m4v/Proyecto-final/mediciones/graficos/horno_ensayo_1.png

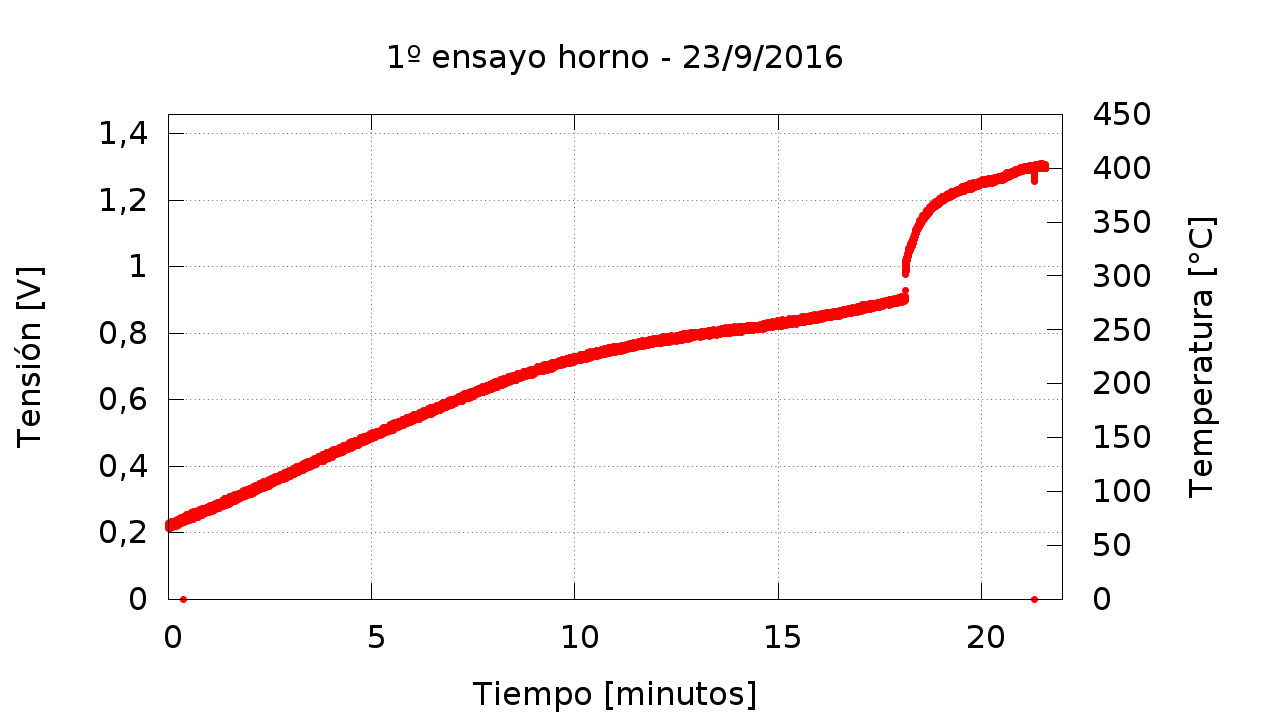
mediciones/graficos/horno_ensayo_1.png
