m4v/Proyecto-final/mediciones/graficos/horno_ensayo_2.png

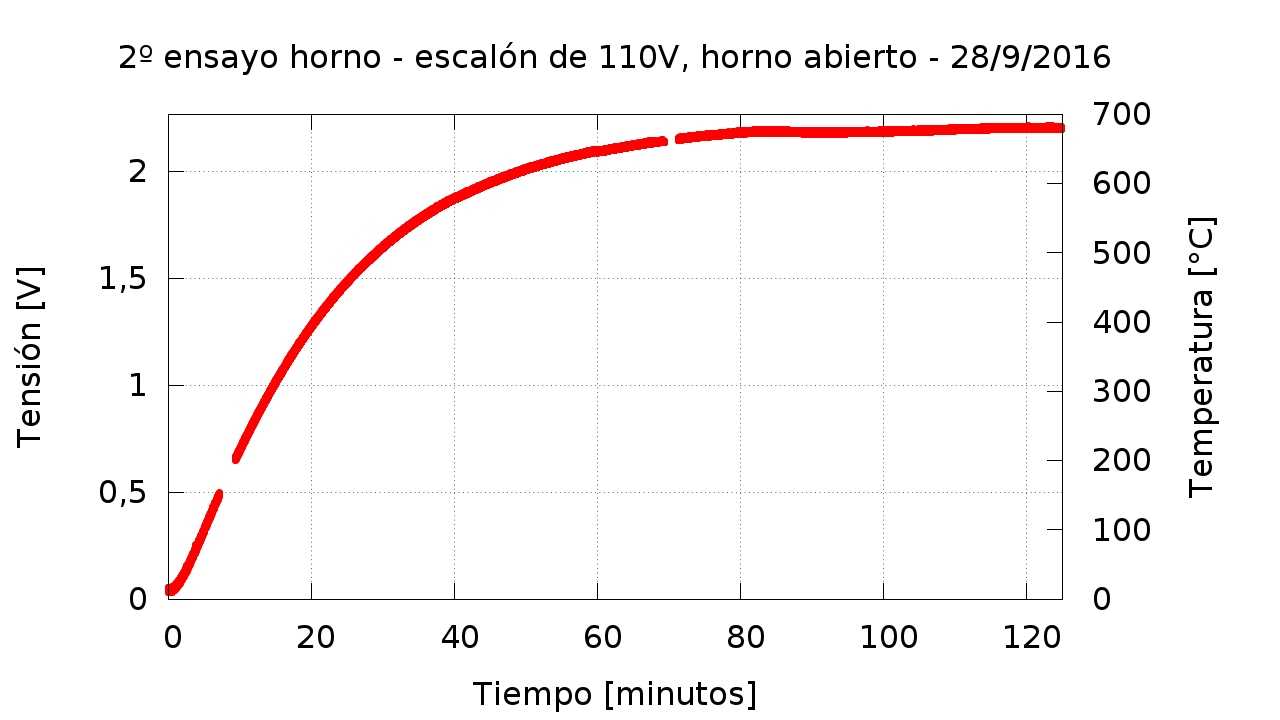
mediciones/graficos/horno_ensayo_2.png
