m4v/Proyecto-final/mediciones/graficos/horno_ensayo_3.png

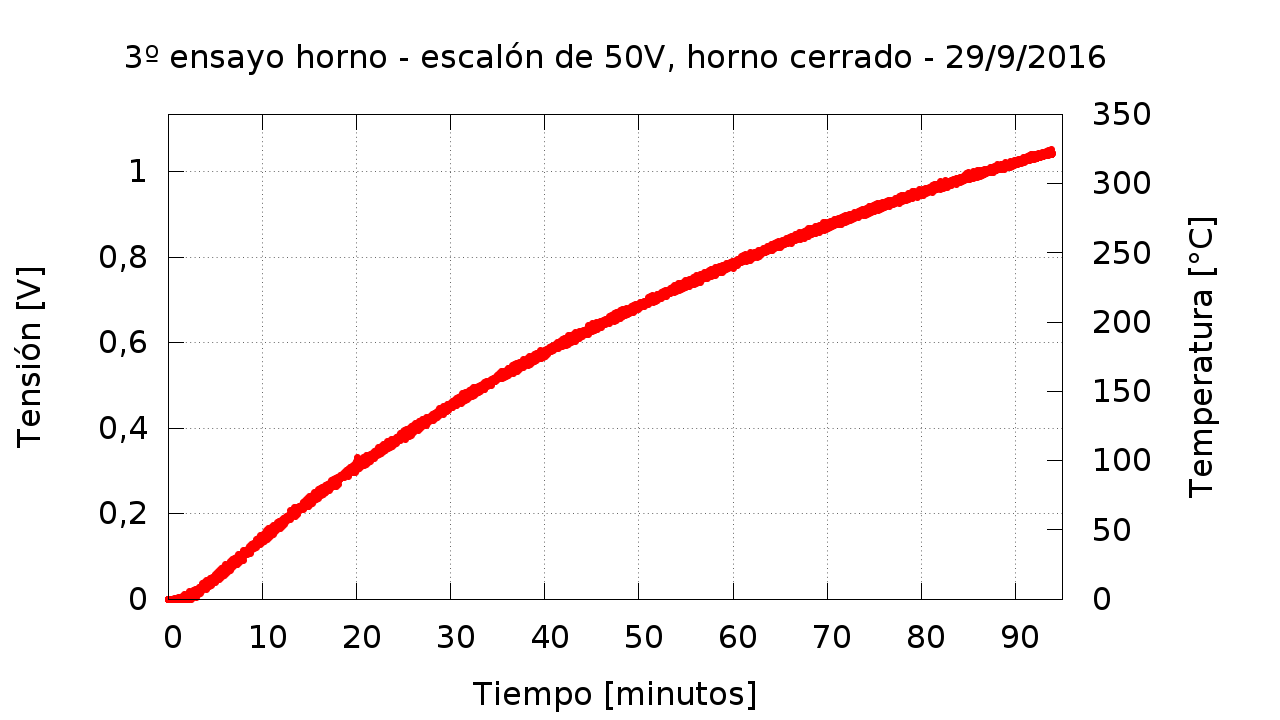
mediciones/graficos/horno_ensayo_3.png
