m4v/Proyecto-final/mediciones/graficos/horno_ensayo_2016-10-04.png

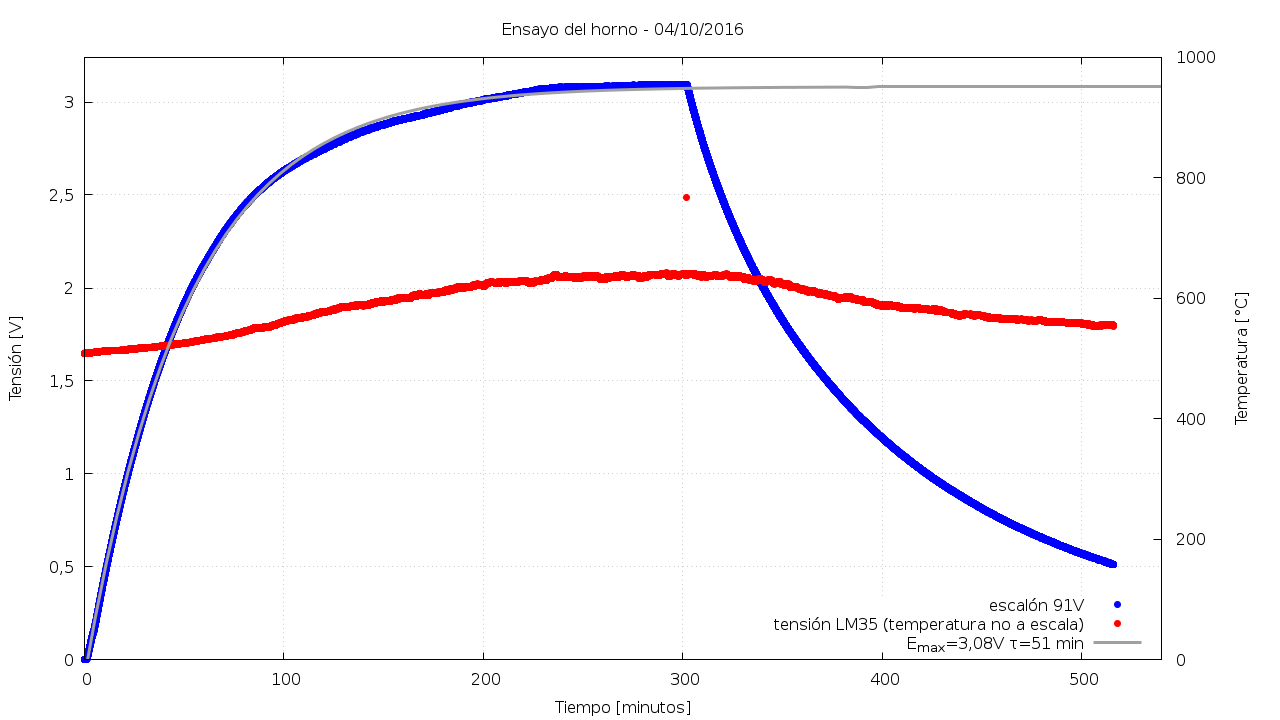
mediciones/graficos/horno_ensayo_2016-10-04.png
