m4v/Proyecto-final/mediciones/graficos/horno_ensayos_2_y_3.png

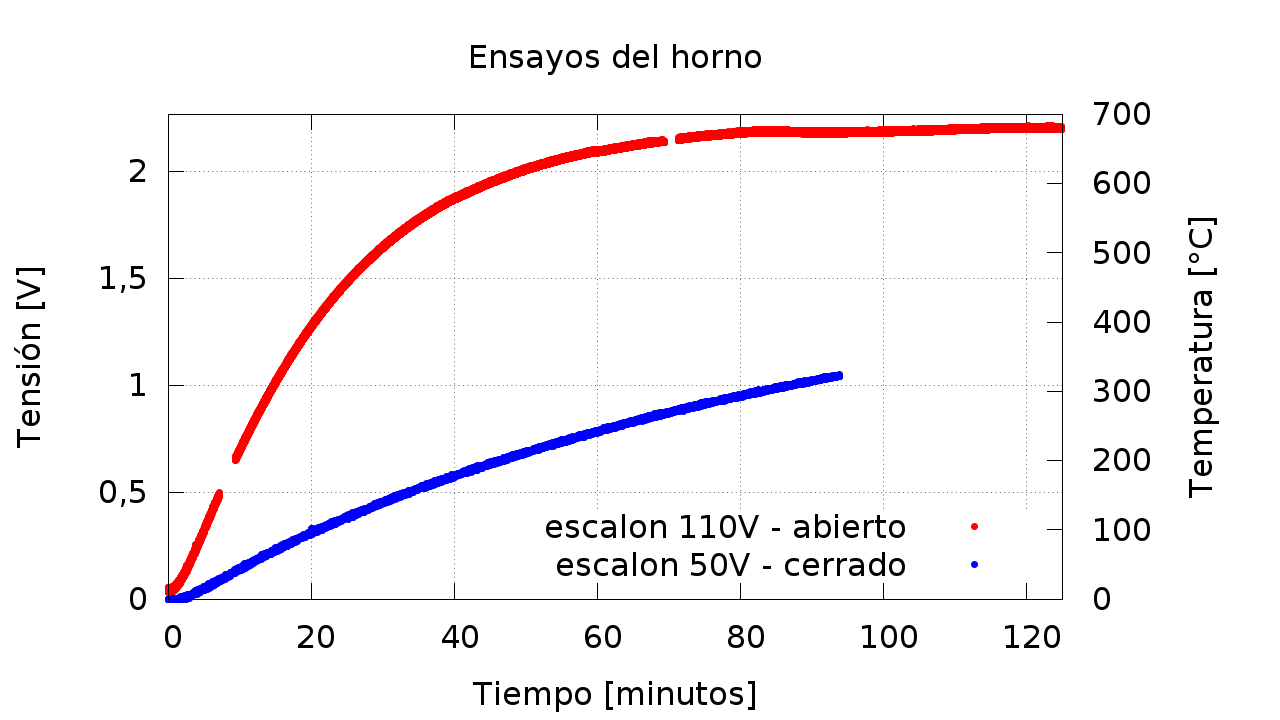
mediciones/graficos/horno_ensayos_2_y_3.png
