m4v/Proyecto-final/mediciones/graficos/horno_ensayos_con_ajuste.png

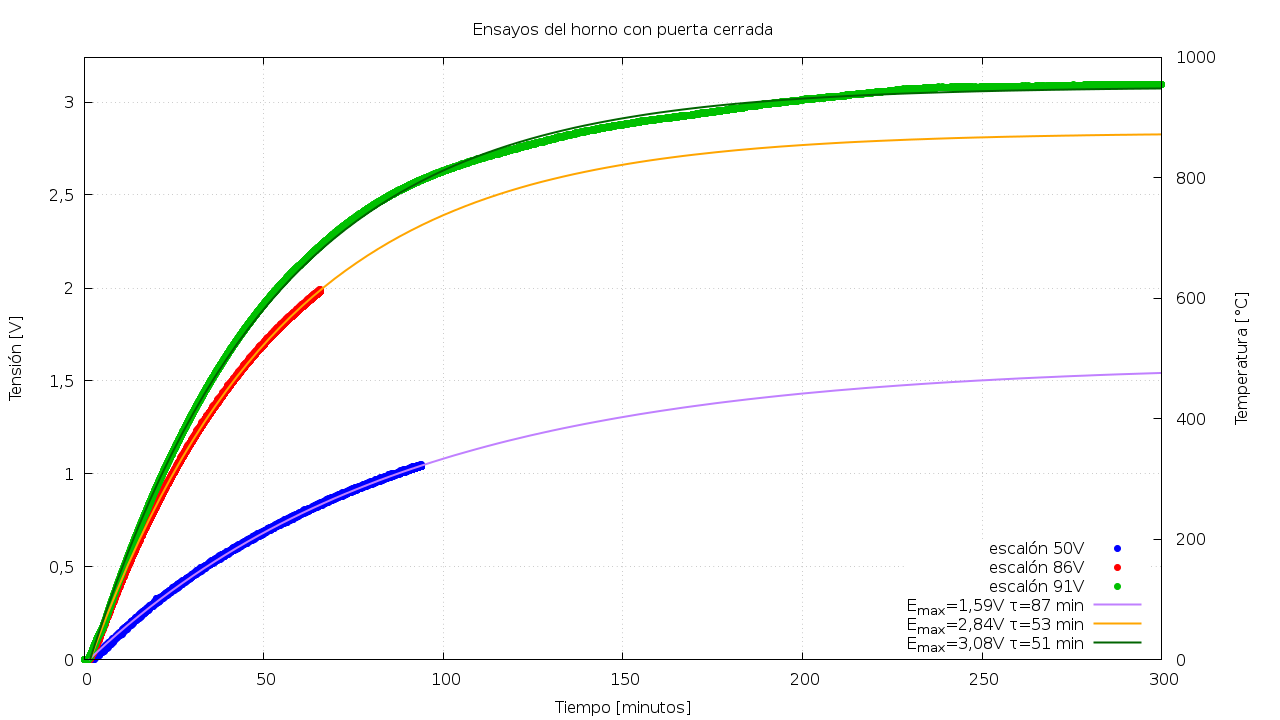
mediciones/graficos/horno_ensayos_con_ajuste.png
