m4v/Proyecto-final/mediciones/graficos/horno_ensayos_con_ajuste_2.png

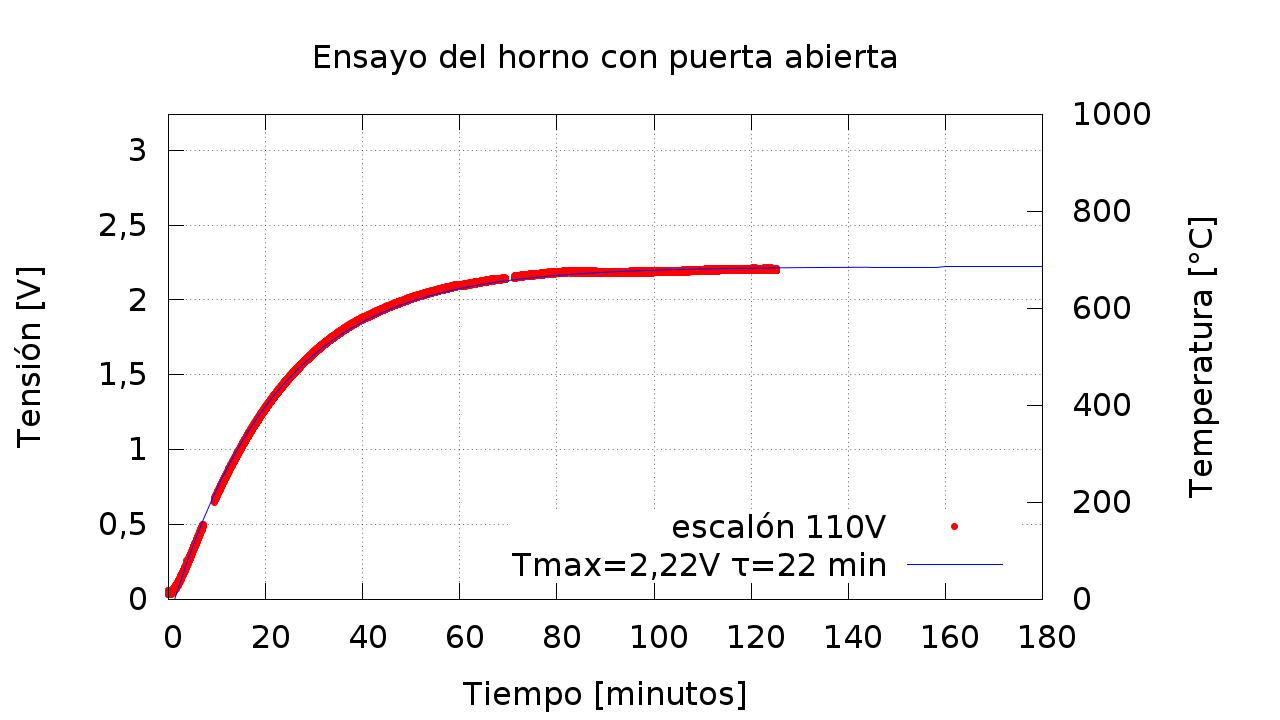
mediciones/graficos/horno_ensayos_con_ajuste_2.png
