m4v/Proyecto-final/mediciones/graficos/horno_informe_control_6.png

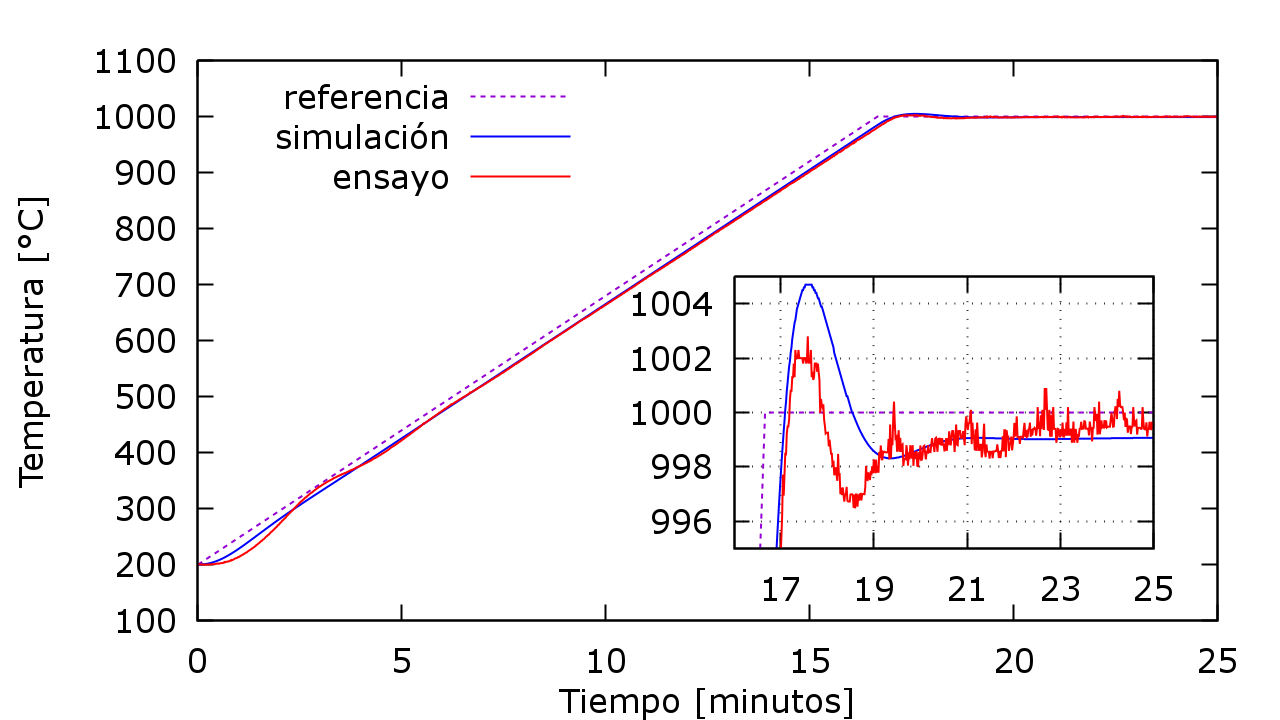
mediciones/graficos/horno_informe_control_6.png
