m4v/Proyecto-final/mediciones/graficos/horno_presentacion_coccion.png

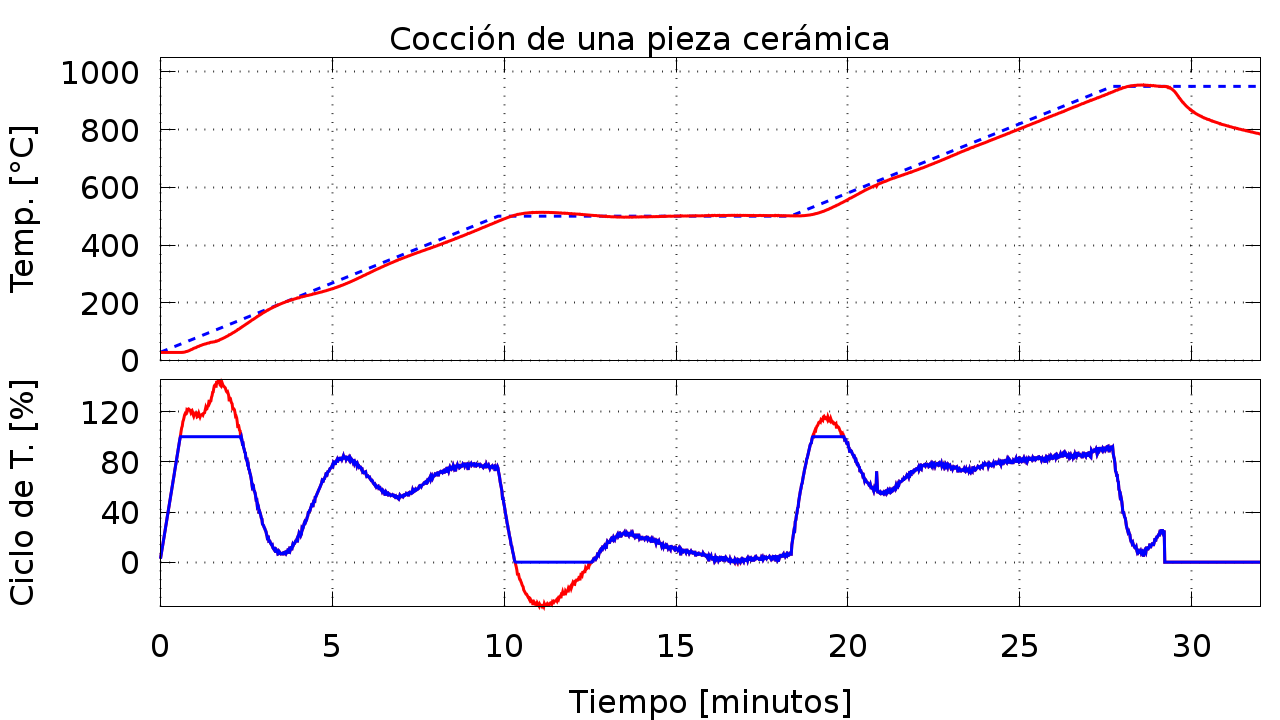
mediciones/graficos/horno_presentacion_coccion.png
