m4v/Proyecto-final/mediciones/graficos/horno_presentacion_escalon.png

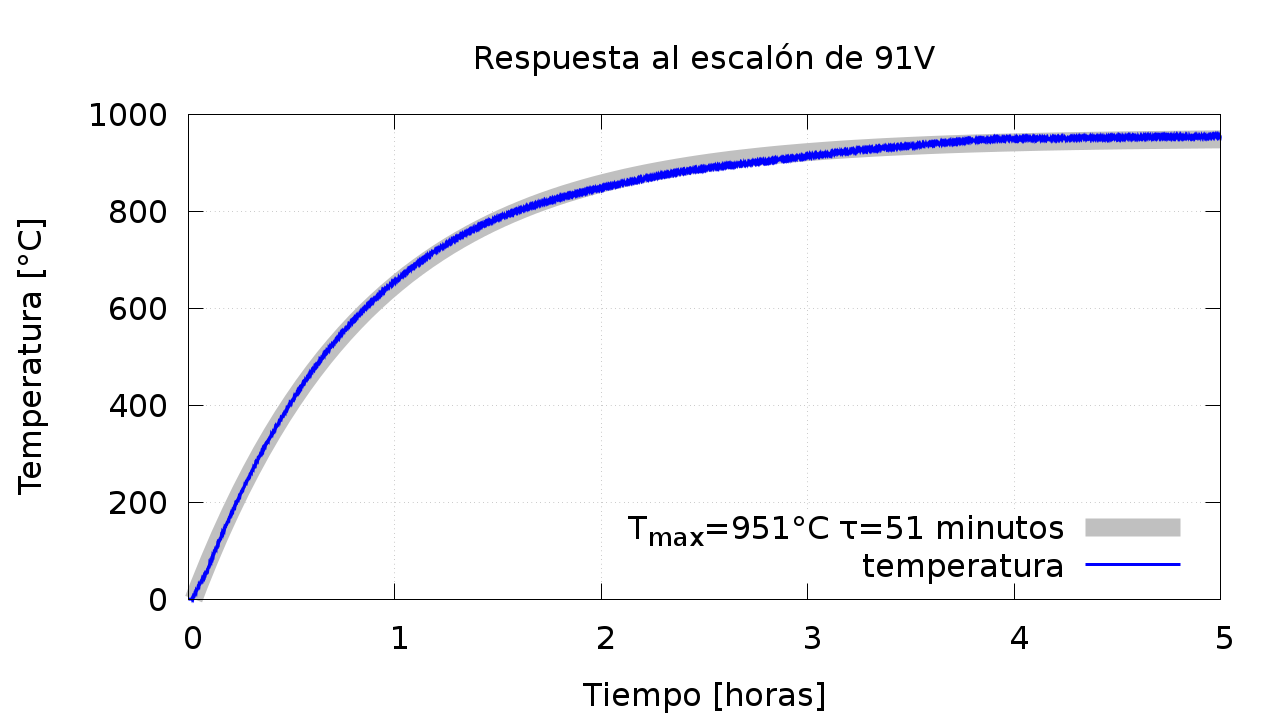
mediciones/graficos/horno_presentacion_escalon.png
