m4v/Proyecto-final/mediciones/graficos/horno_presentacion_pi.png

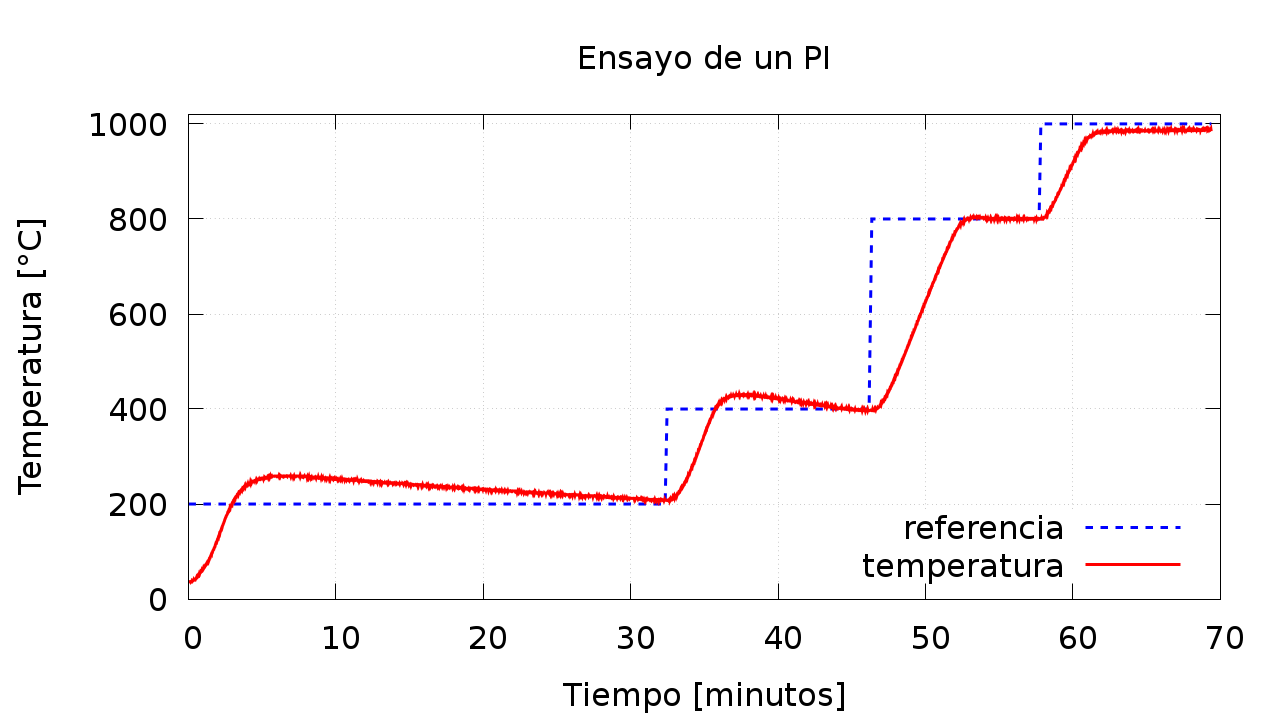
mediciones/graficos/horno_presentacion_pi.png
