m4v/Proyecto-final/mediciones/graficos/horno_presentacion_pi_1.png

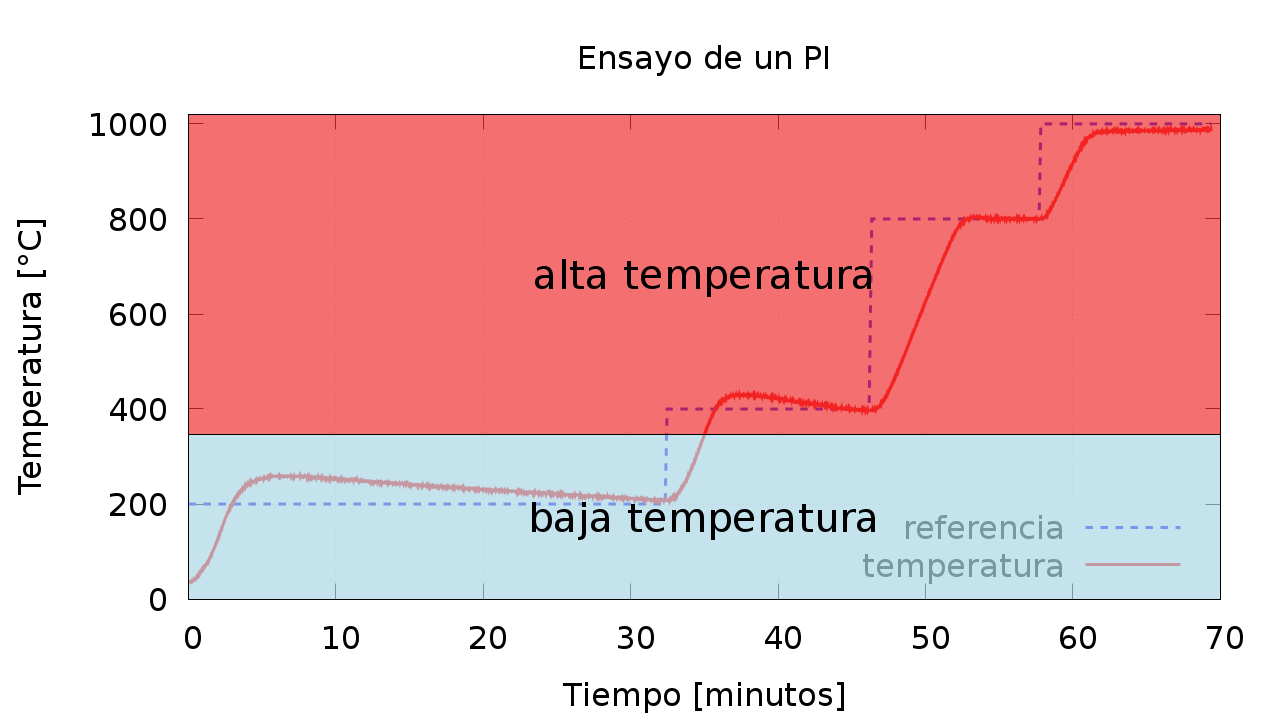
mediciones/graficos/horno_presentacion_pi_1.png
