m4v/Proyecto-final/mediciones/graficos/horno_presentacion_programa_2.png

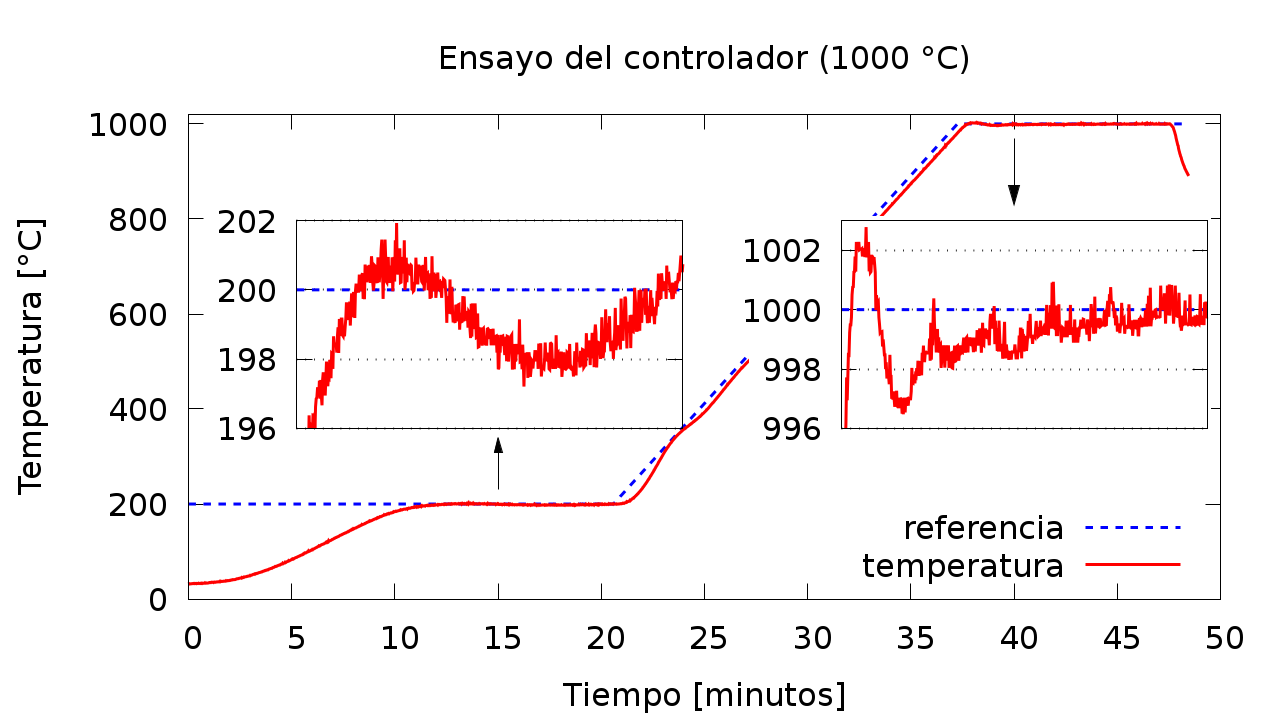
mediciones/graficos/horno_presentacion_programa_2.png
