m4v/Proyecto-final/mediciones/graficos/horno_presentacion_programa_3.png

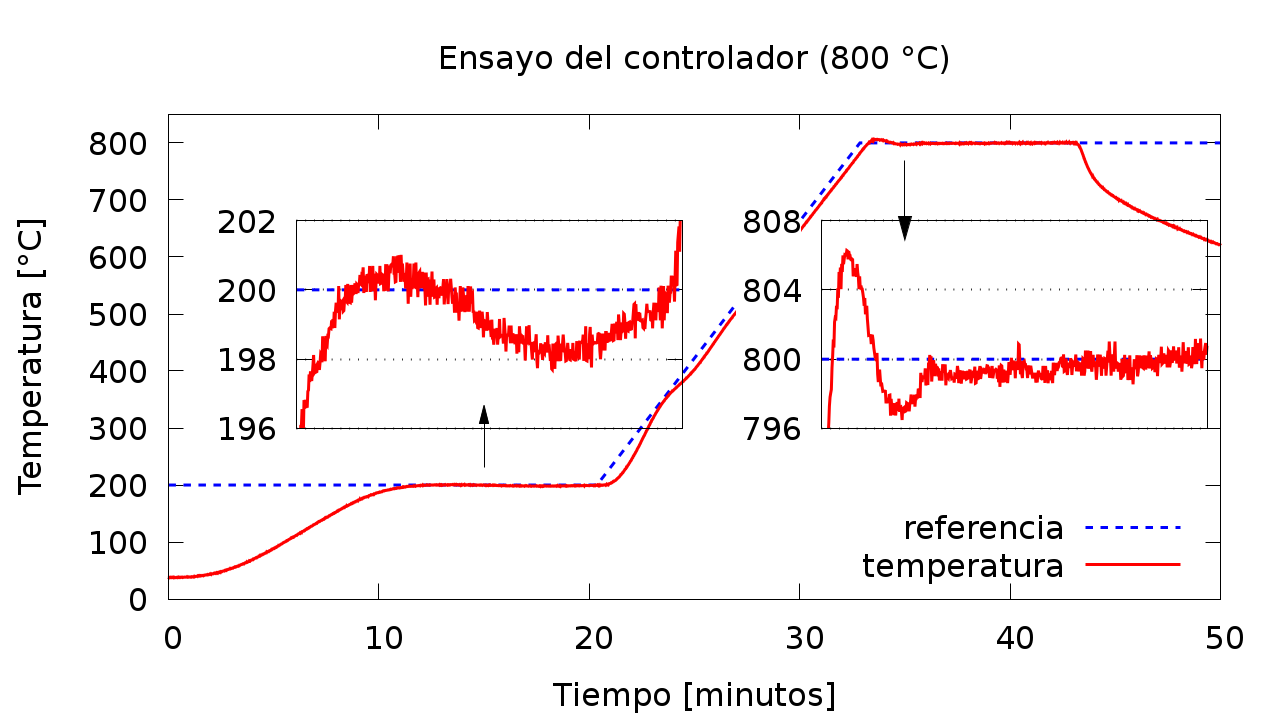
mediciones/graficos/horno_presentacion_programa_3.png
