m4v/Proyecto-final/mediciones/graficos/horno_presentacion_respuestas.png

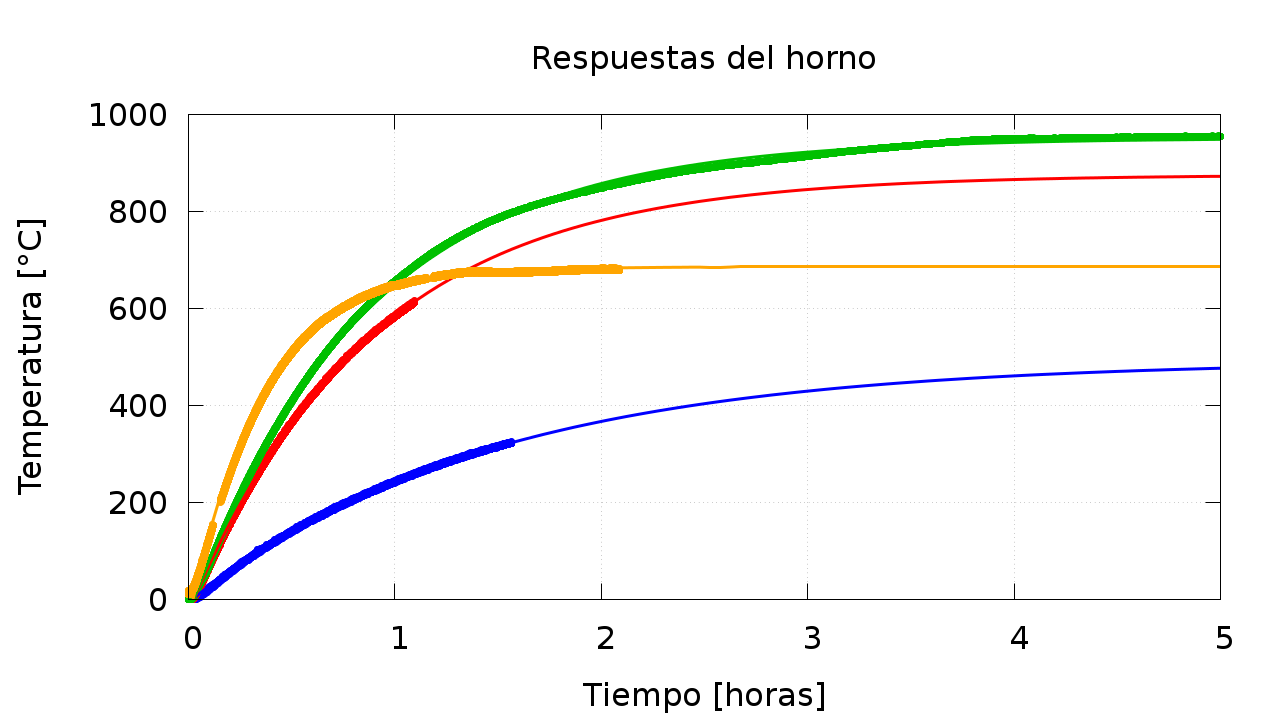
mediciones/graficos/horno_presentacion_respuestas.png
