m4v/Proyecto-final/mediciones/graficos/horno_programa_1.png

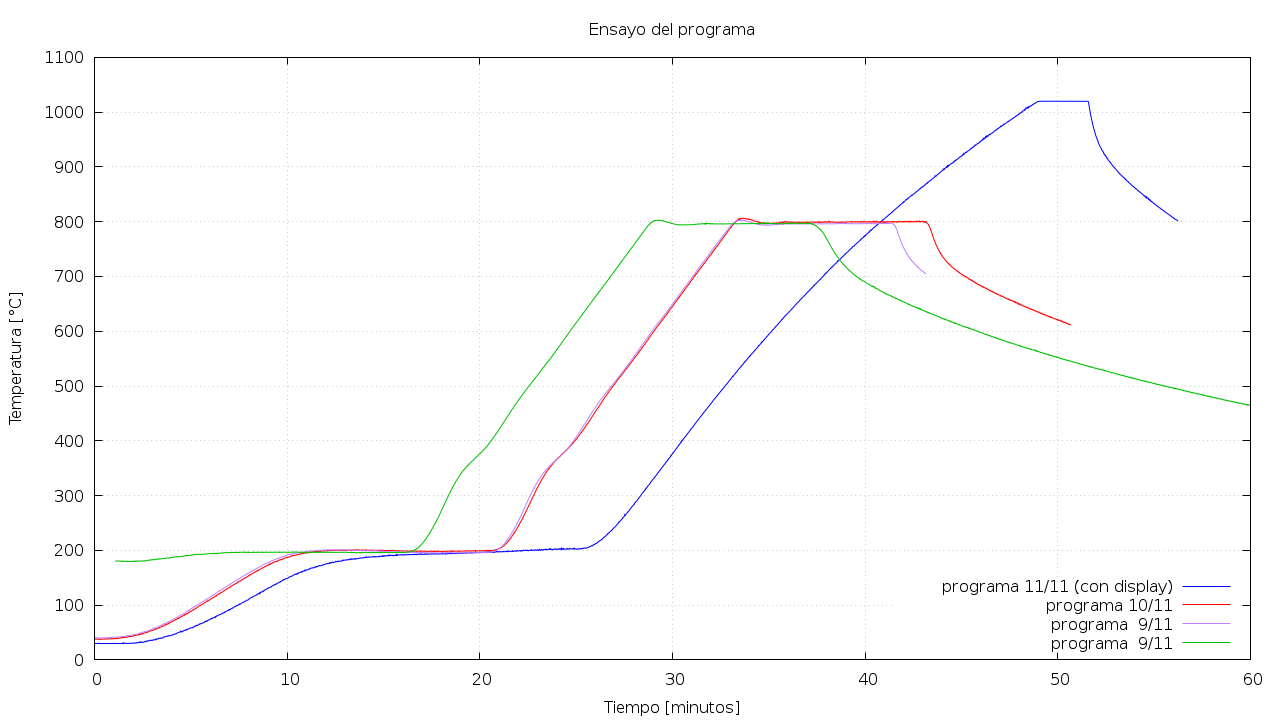
mediciones/graficos/horno_programa_1.png
