m4v/Proyecto-final/mediciones/graficos/horno_programa_2.png

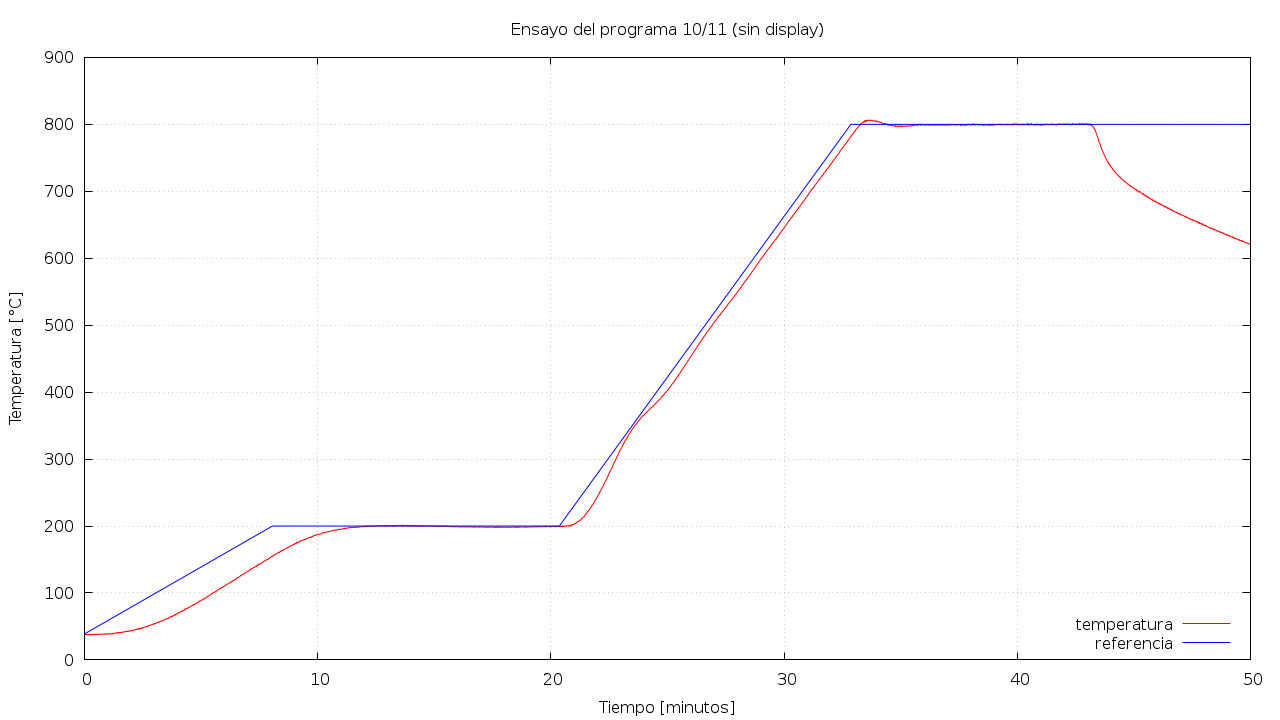
mediciones/graficos/horno_programa_2.png
