m4v/Proyecto-final/mediciones/graficos/horno_programa_3.png

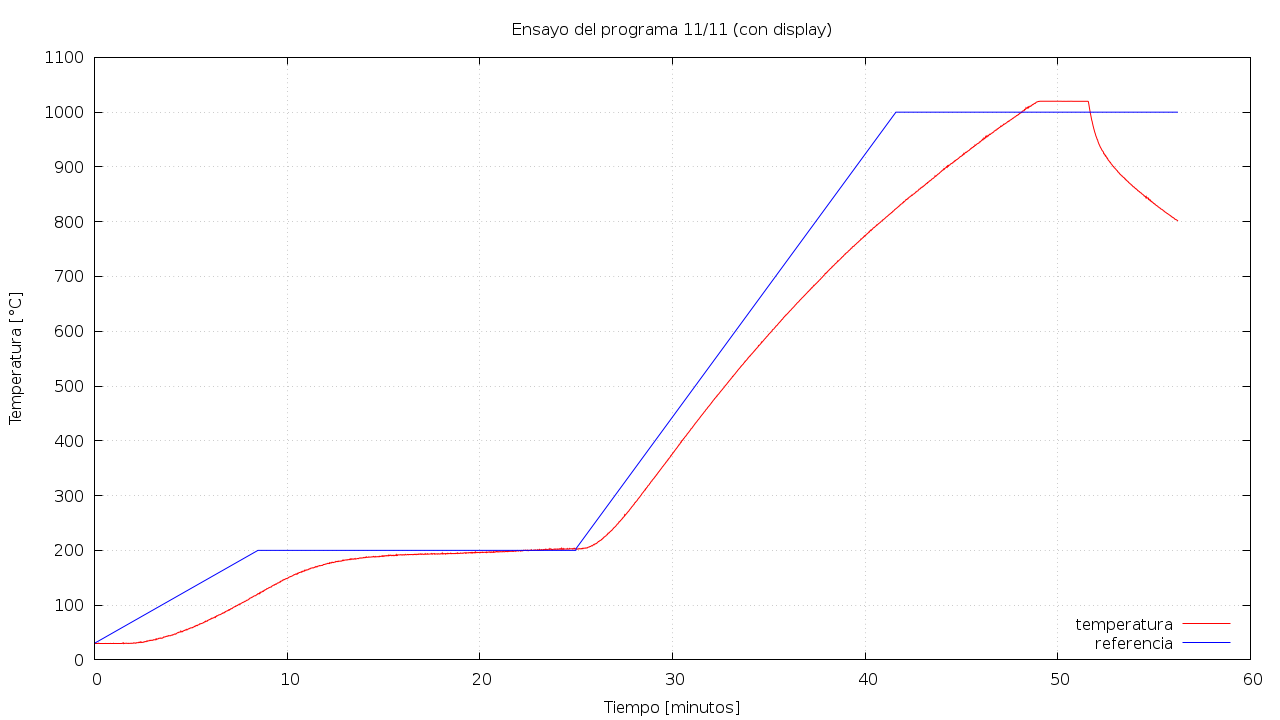
mediciones/graficos/horno_programa_3.png
