m4v/Proyecto-final/mediciones/graficos/horno_programa_4.png

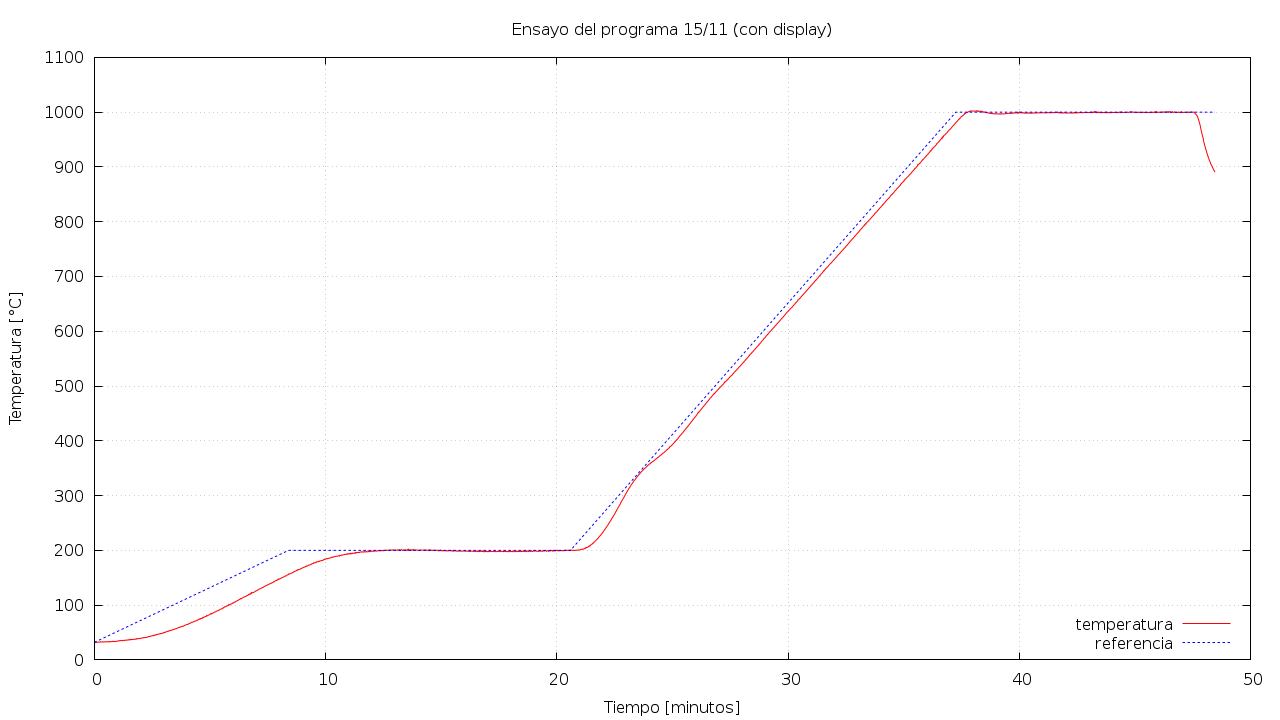
mediciones/graficos/horno_programa_4.png
