m4v/Proyecto-final/mediciones/graficos/horno_programa_5.png

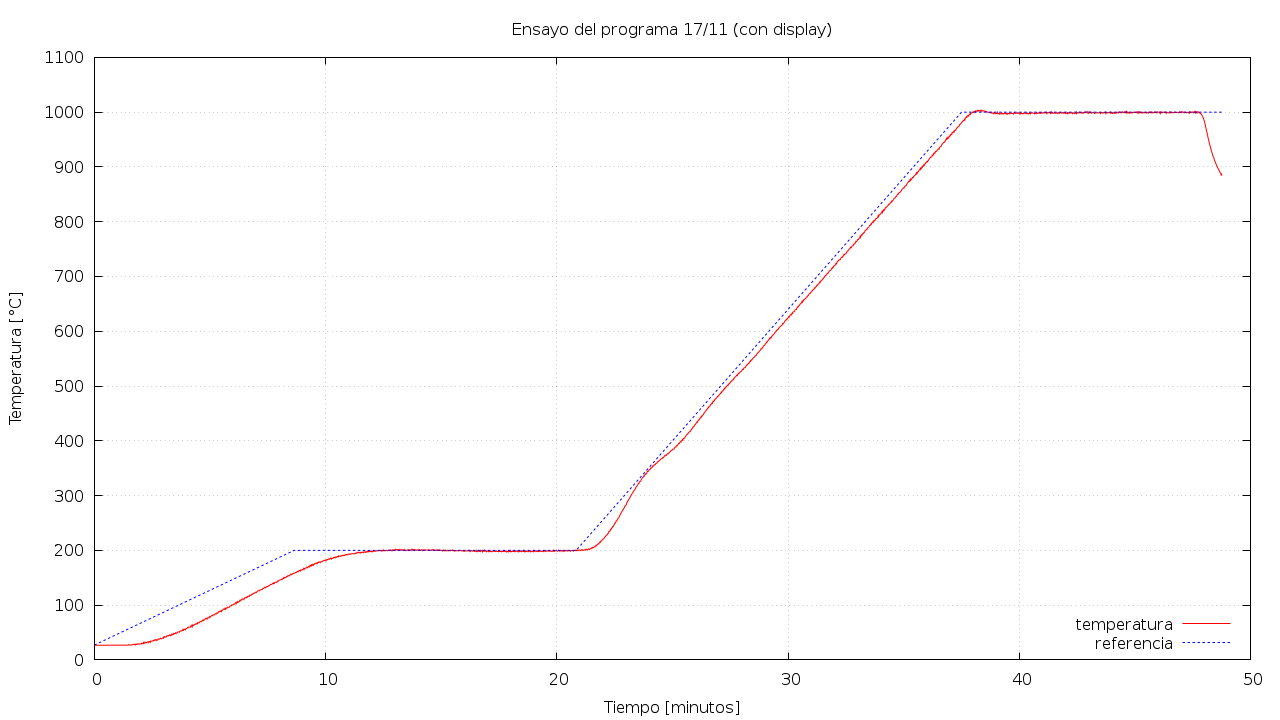
mediciones/graficos/horno_programa_5.png
