m4v/Proyecto-final/mediciones/graficos/horno_pwm1.png

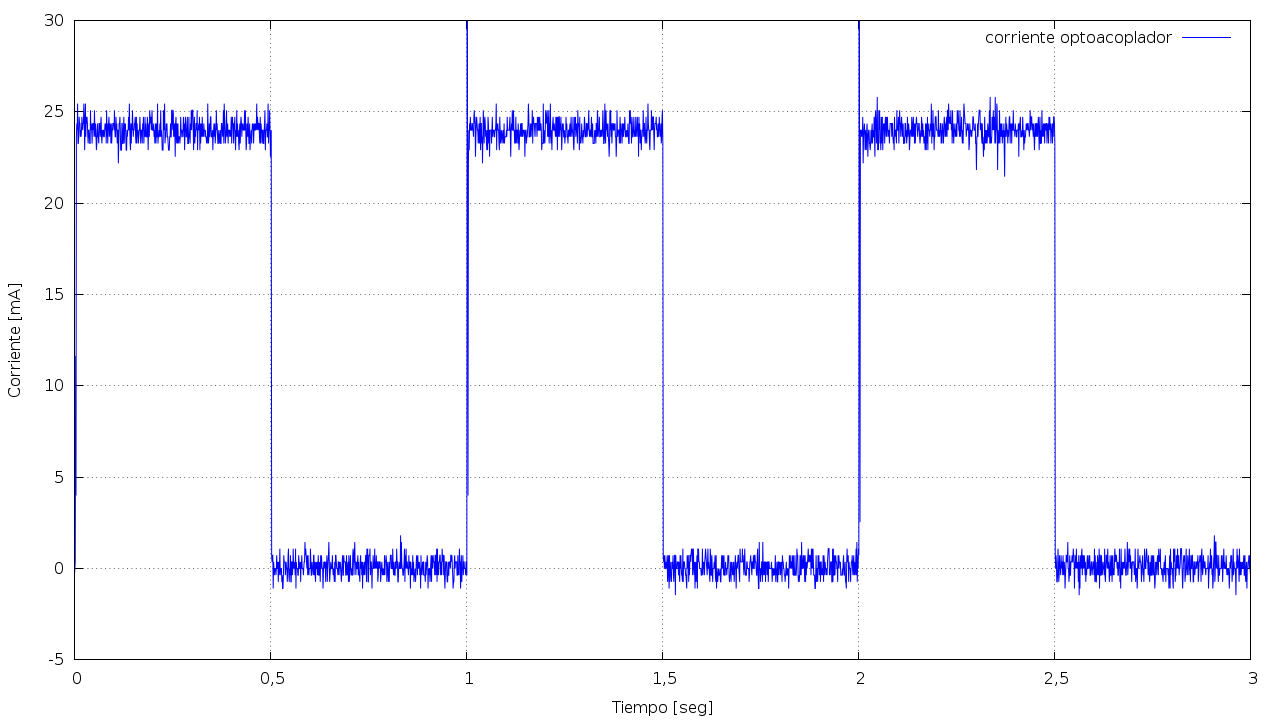
mediciones/graficos/horno_pwm1.png
