m4v/Proyecto-final/mediciones/graficos/horno_pwm2.png

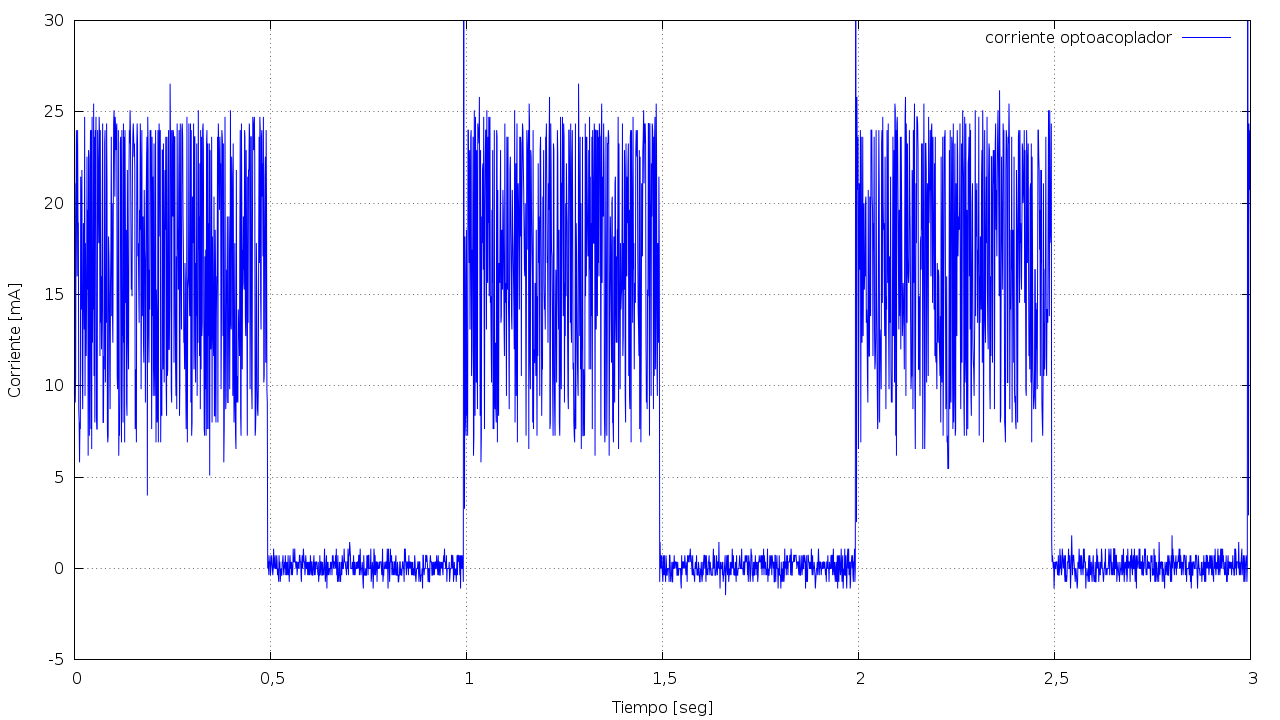
mediciones/graficos/horno_pwm2.png
