m4v/Proyecto-final/mediciones/graficos/horno_pwm3.png

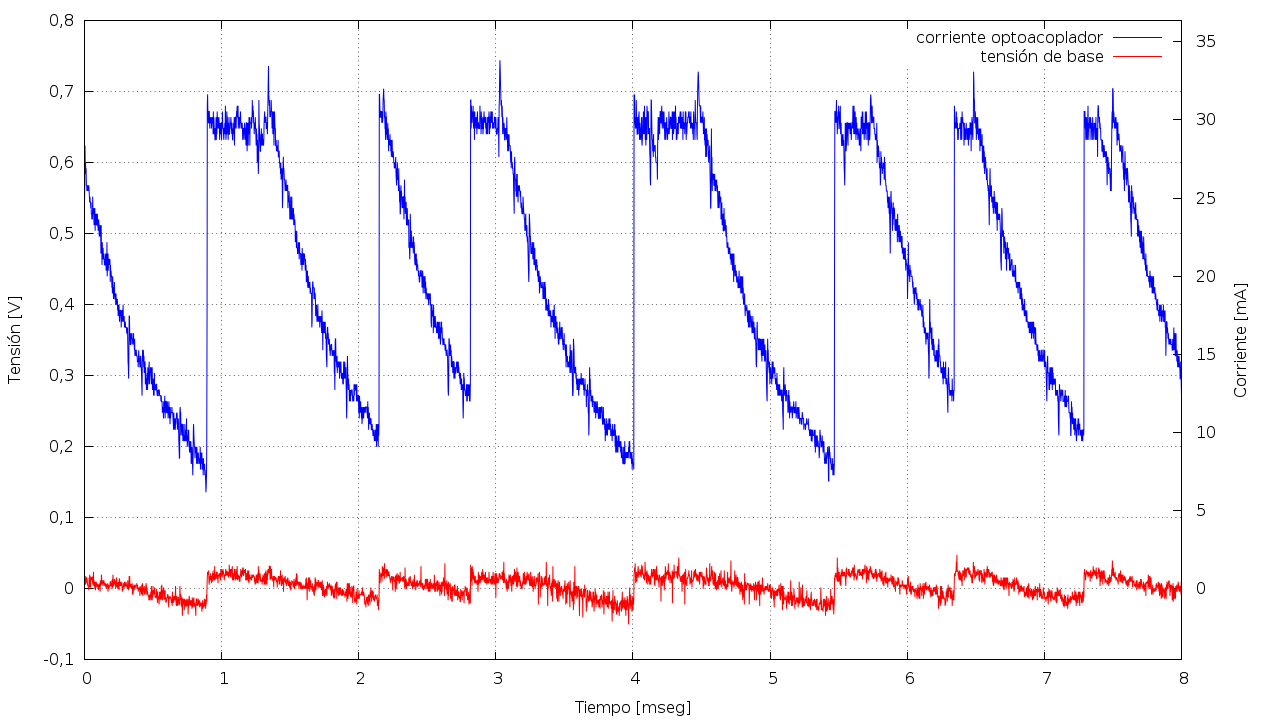
mediciones/graficos/horno_pwm3.png
