m4v/Proyecto-final/octave/pantalla.png

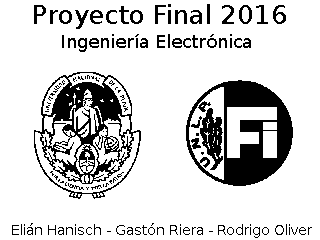
octave/pantalla.png
