m4v/Proyecto-final/kicad/horno_BOM.ods

Ref | Qnty | Value | Cmp name | Footprint | Description | Elián | Gastón | Rodri
C2, C1, C4, C3, | 4 | 220nF | C |  | Capacitor 224 (que no sean caramelos grandes)
C7, C5, C11, C9, C14, C8, C6, C12, C10, | 9 | 0,1uF | C |  | Capacitor 104 | 9 tengo
C13, | 1 | 1uF | CP | Capacitor radial P2.5 | electrolítico | tengo
P1, | 2 |  | CONN_01x22 | conector 1x22 | Connector LPCXpresso LPC1769
P3, | 1 |  | CONN_01X02 | Bornera 2 | para la termocupla | tengo
P4, P5 | 2 |  | CONN_01X02 | tira de pines 1x2 | uno es para alimentación 24V | tengo hembra solamente (para alimentación deberían ser machos)
P6, | 1 |  | CONN_01X05 | Conector 1x5 | conector para el motor | tengo
P7, | 1 |  | CONN_02X11 | Conector de pines 2x11 | pantalla
P8, P10 | 2 |  | CONN_01X03 | tira de pines 1x3 | uno es para alimentación +5V -5V | tengo hembra solamente (para alimentación deberían ser machos)
P9, | 1 |  | CONN_02X12 | conector de pines 2x12 | conector para puertos que sobran
Q1, | 1 | BC547 | BC547 | TO-92 | transistor | tengo
R1, | 1 | 10k | R | Resistor_Horizontal_RM10mm | Resistor | resistores no miré aún
R3, R2, R7, | 3 | 56k | R | Resistor_Horizontal_RM10mm | Resistor
R4, R8, | 2 | 330k | R | Resistor_Horizontal_RM10mm | Resistor
R5, | 1 | 1,5k | R | Resistor_Horizontal_RM10mm | Resistor metal film
R6, | 1 | 120k | R | Resistor_Horizontal_RM10mm | Resistor metal film
RV2, RV1, RV3, | 3 | POT | POT |  | trimmers
SW1, | 1 | RST | SW_PUSH | SW_PUSH_6mm | microswitch común | tengo
U2, U1, U4, | 3 | OP07 | OP07 | DIP-8 | Op amp
U3, | 1 | LTC1050 | LTC1050 | DIP-8 | Zero drift operational amplifier
U5, | 1 | L293D | L293D | DIP-16 | driver de motor | tengo uno de los que compraron
U6, | 1 | LM35 | LM35 | TO-92 | sensor de temperatura | tengo
