m4v/Proyecto-final/kicad/documentación/esquematico_rev3_color.pdf

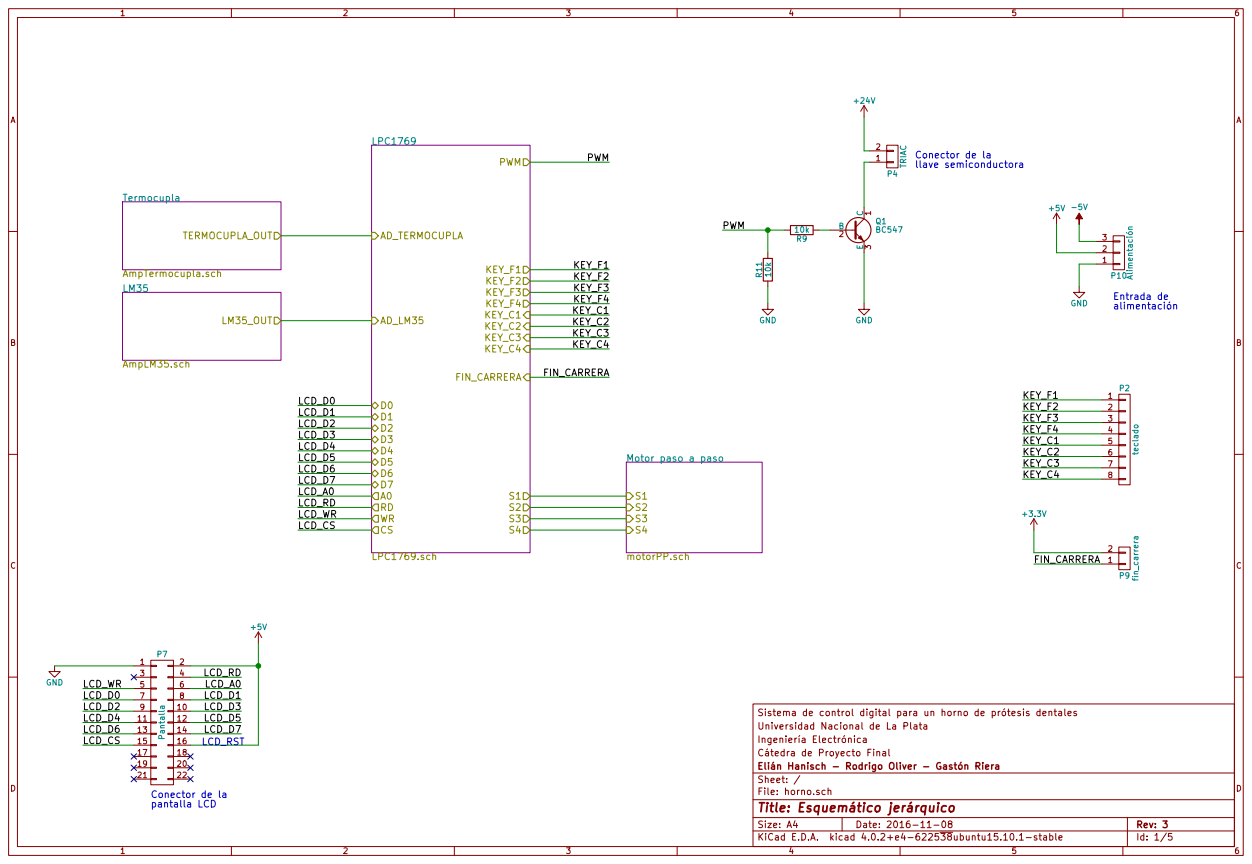
[picture p45: page 1]

llave semiconductora Conector de la

KEY_F2 | | 2
KEY_F3 | | 3
KEY_F4 | | 4
KEY_C1 | 5
KEY_C2 | 6
KEY_C3 | 7

Motor paso a paso motorPP.sch S1

Ingeniería Electrónica Universidad Nacional de La Plata Sistema de control digital para un horno de prótesis dentales

LCD_D4 11 | 12 | LCD_D5

13 | 14 | LCD_D7

LCD_CS 15 | 16 | LCD_RST

Cátedra de Proyecto Final
File: horno.sch Sheet: / Elián Hanisch - Rodrigo Oliver - Gastón Riera

Id: 1/5 Title: Esquemático jerárquico

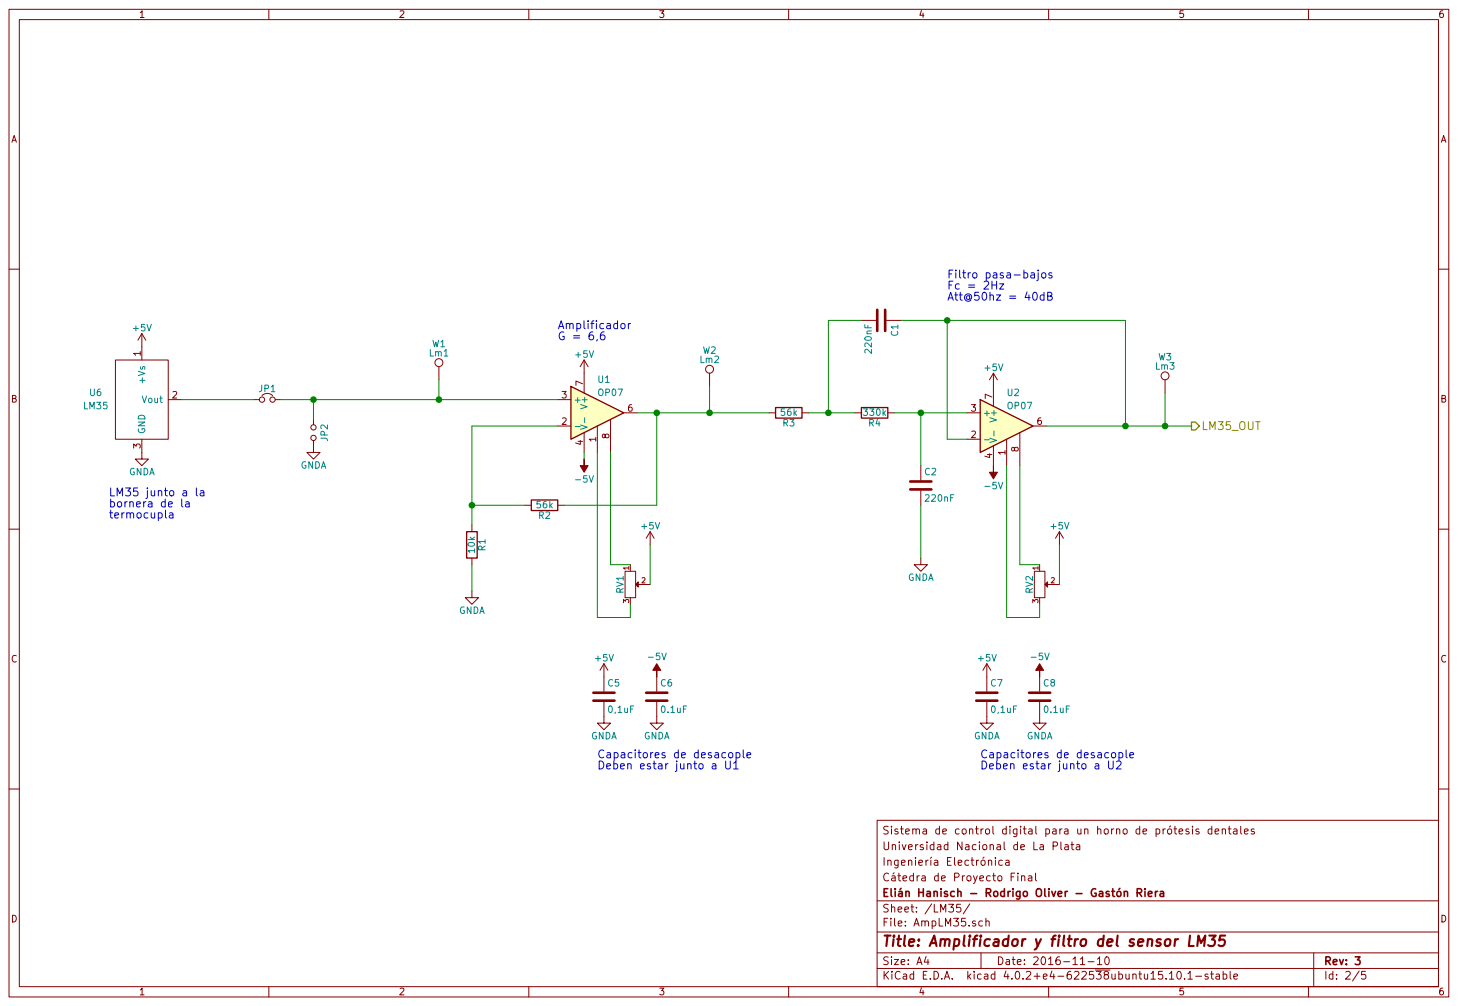
[picture p46: page 2]

Filtro pasa-bajos Fc = 2Hz Att@50hz = 40dB

3 RV1 +5V LM35 junto a la bornera de la
termocupla

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

Cátedra de Proyecto Final
File: AmpLM35.sch Sheet: /LM35/ Elián Hanisch - Rodrigo Oliver - Gastón Riera

Id: 2/5 Title: Amplificador y filtro del sensor LM35

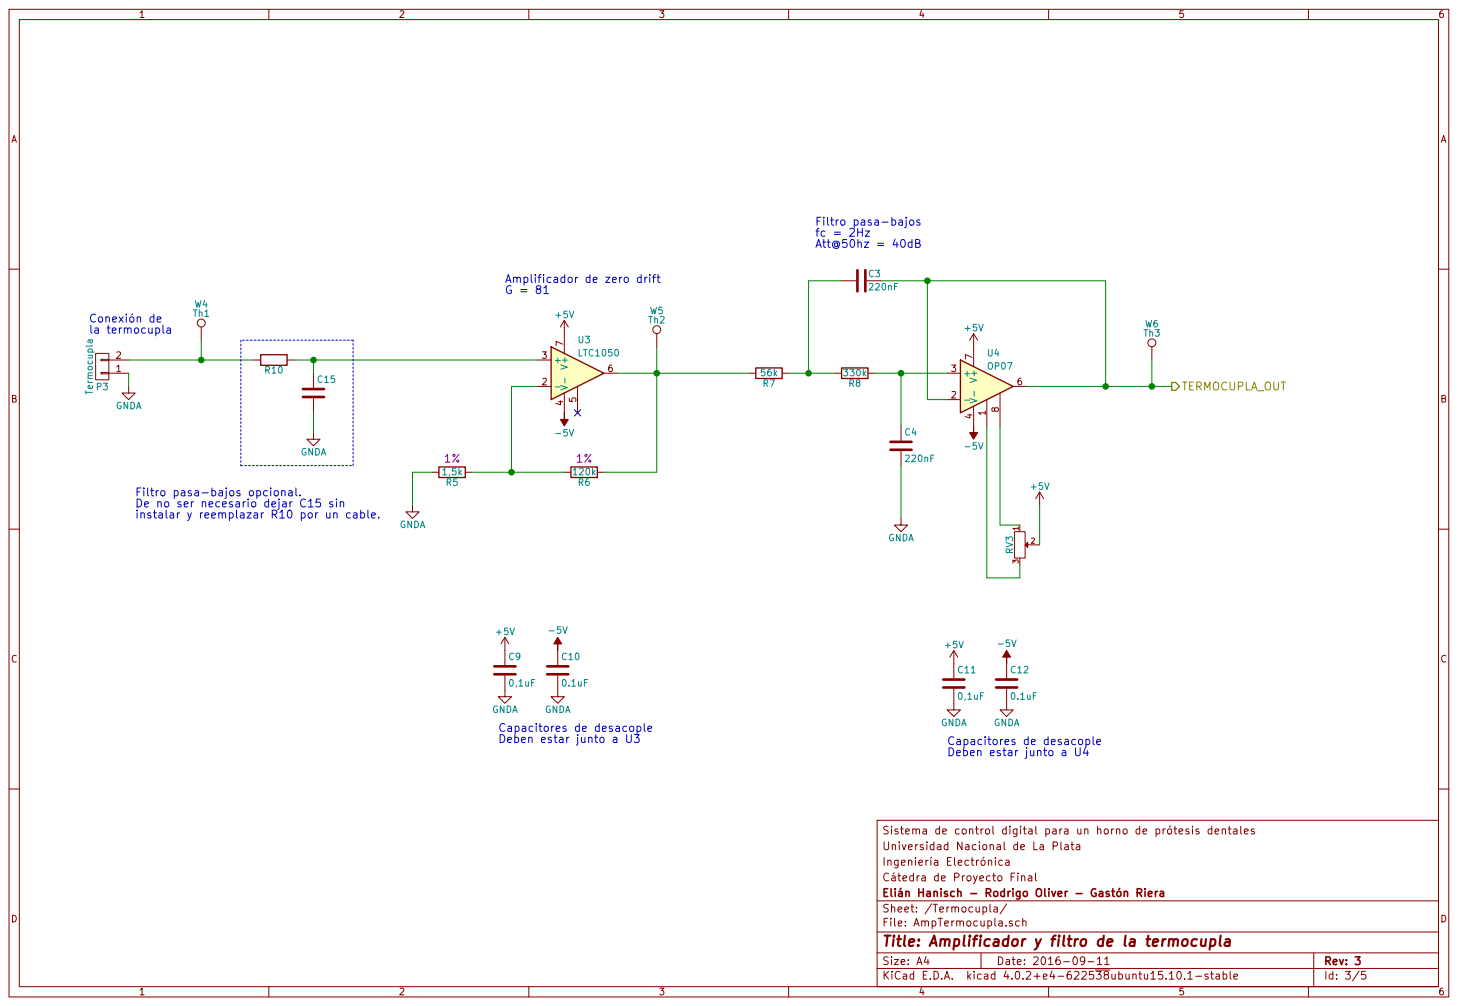
[picture p47: page 3]

Amplificador de zero drift

De no ser necesario dejar C15 sin

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

Cátedra de Proyecto Final
Elián Hanisch - Rodrigo Oliver - Gastón Riera
Sheet: /Termocupla/
File: AmpTermocupla.sch
Id: 3/5 Title: Amplificador y filtro de la termocupla

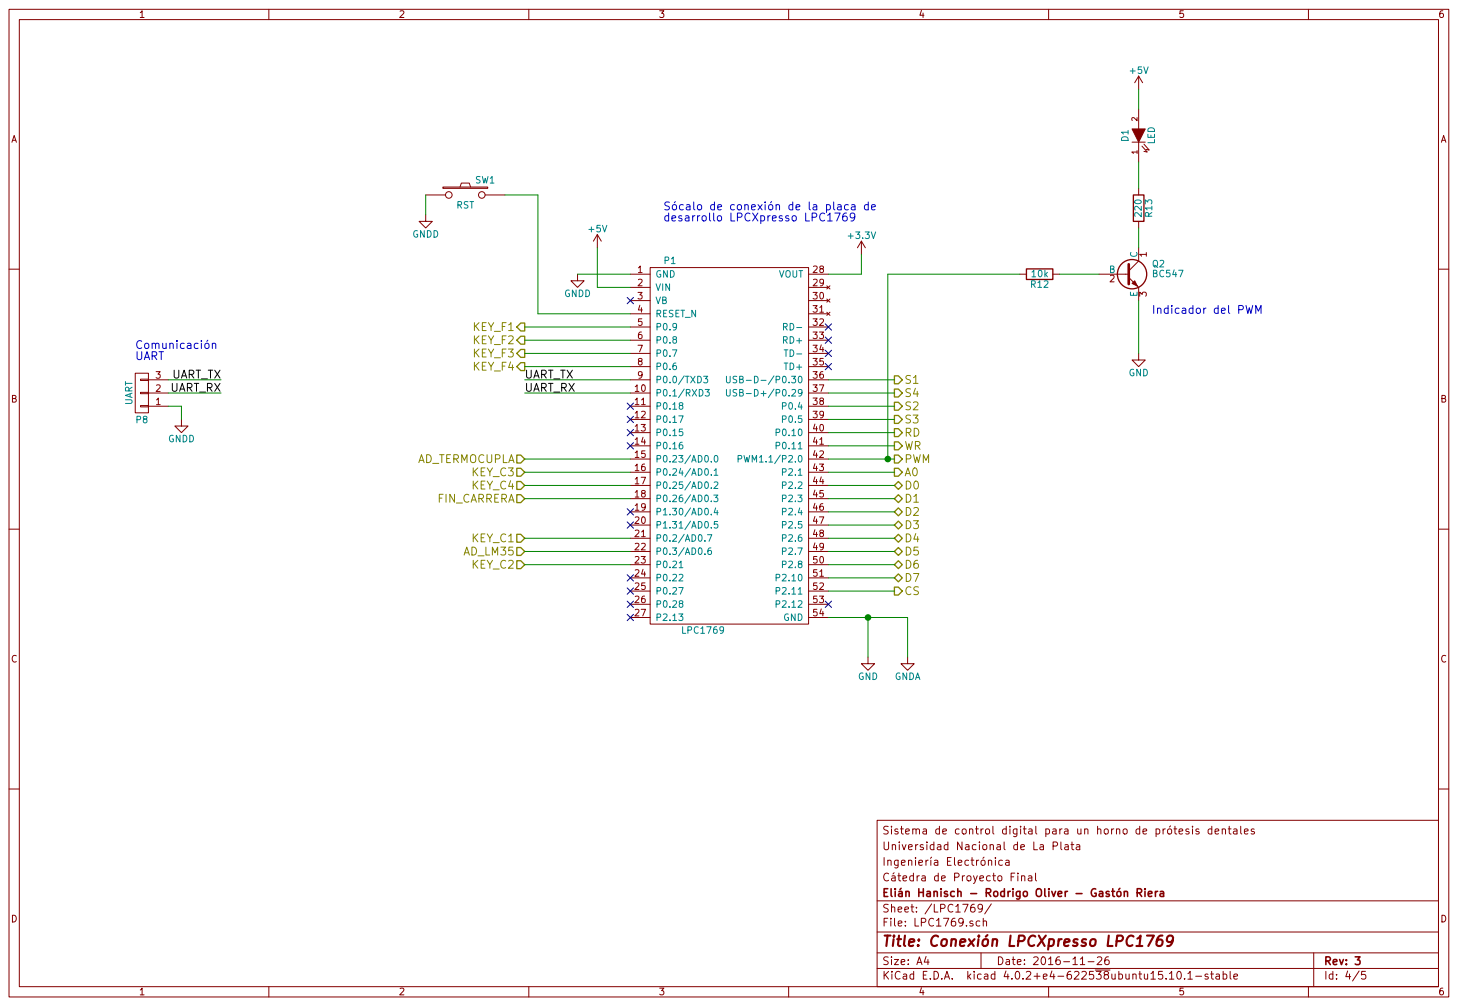
[picture p48: page 4]

Sócalo de conexión de la placa de

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

Cátedra de Proyecto Final
File: LPC1769.sch Sheet: /LPC1769/ Elián Hanisch - Rodrigo Oliver - Gastón Riera

Id: 4/5 Title: Conexión LPCXpresso LPC1769

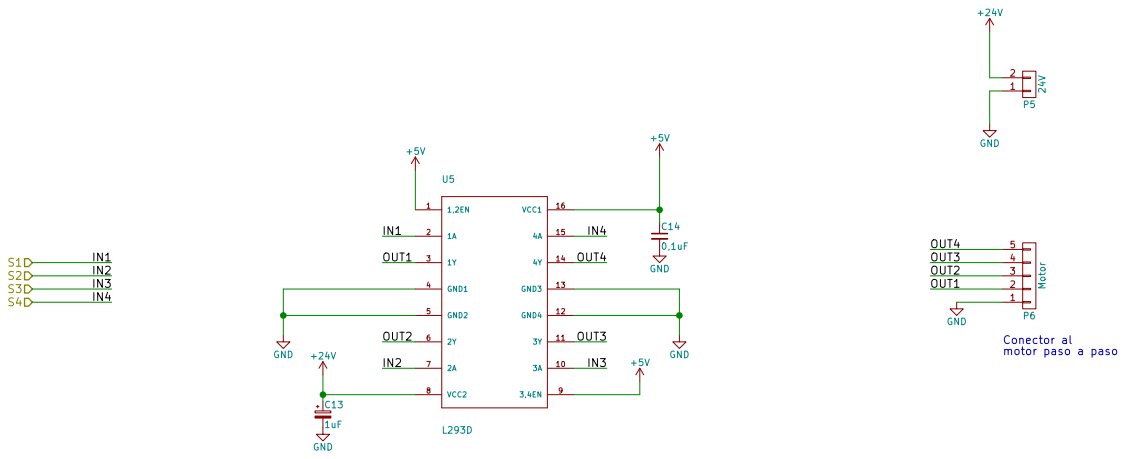
[picture p49: page 5]
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

Cátedra de Proyecto Final
Elián Hanisch - Rodrigo Oliver - Gastón Riera
File: motorPP.sch Sheet: /Motor paso a paso/
Id: 5/5 Title: Driver del motor paso a paso
