m4v/Proyecto-final/kicad/documentación/pcb_copper.pdf

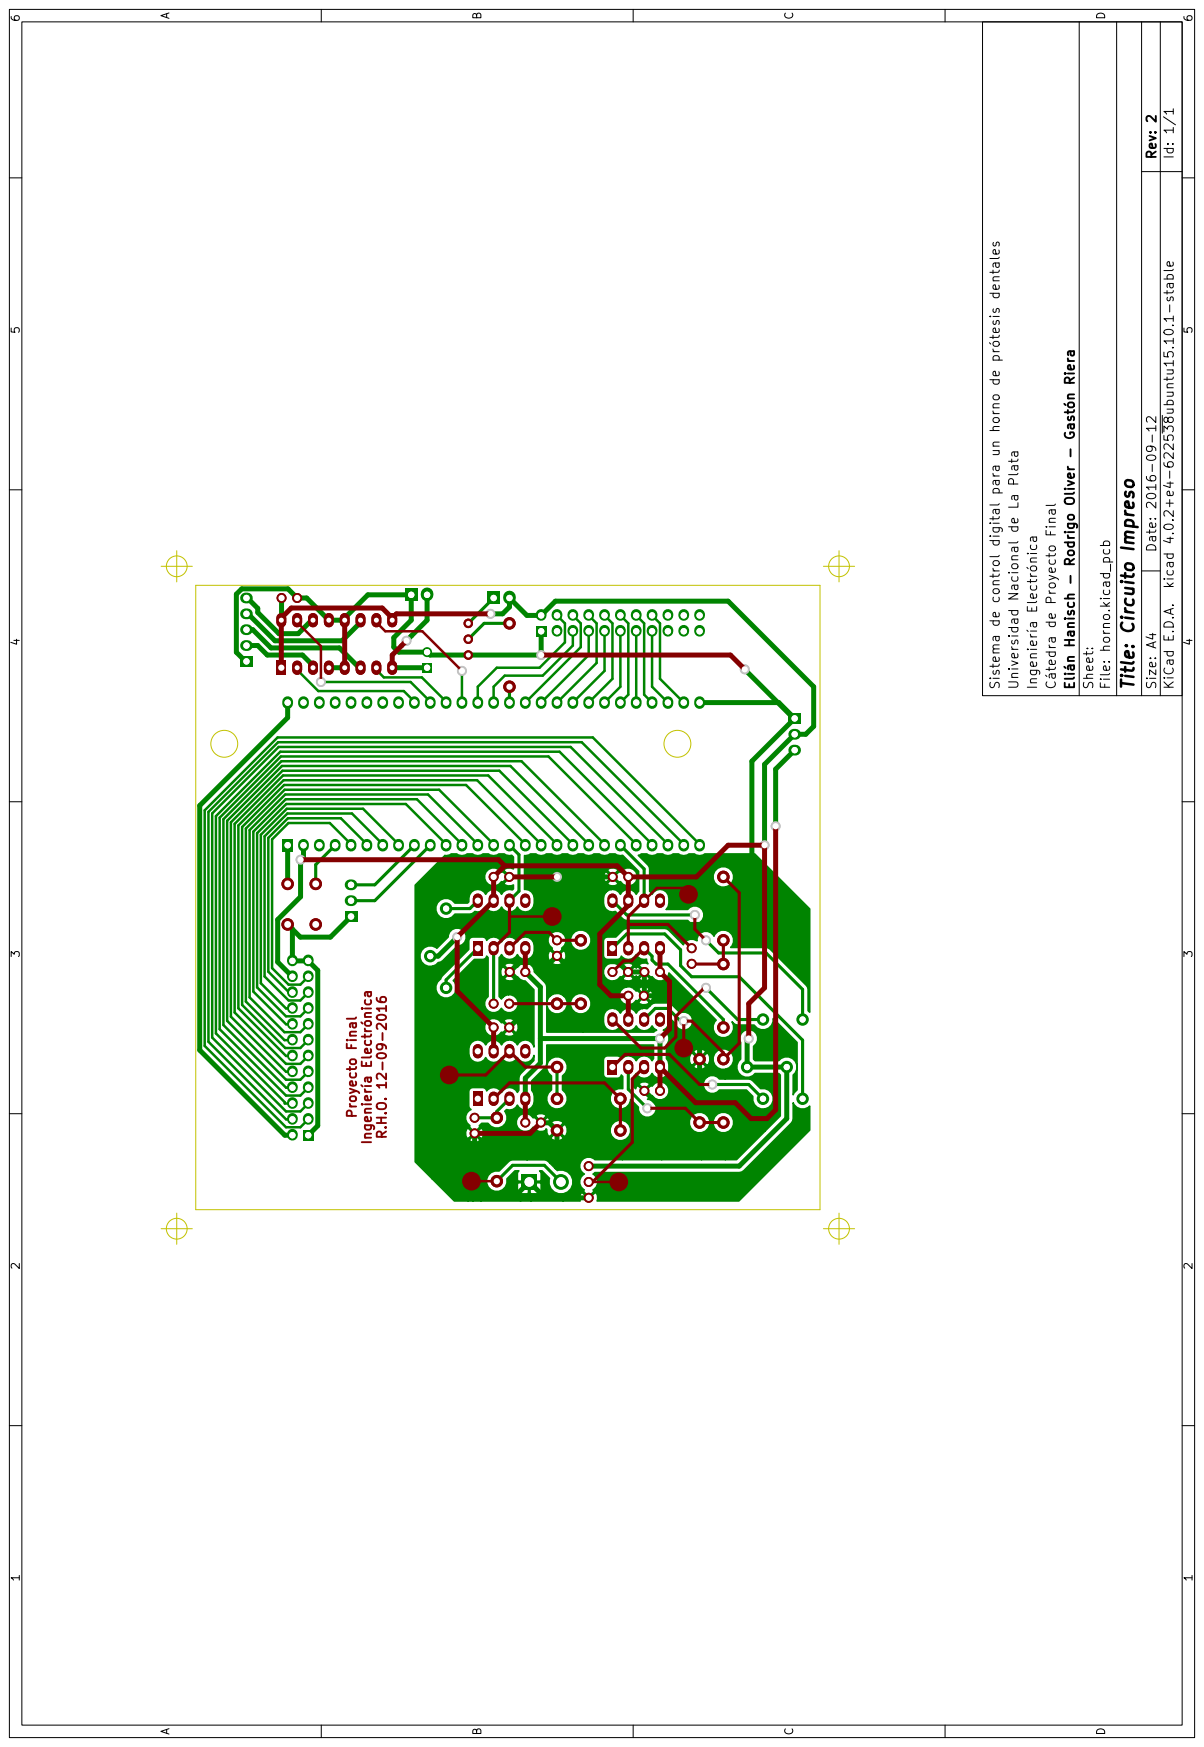
[picture p50: page 1]
