m4v/Proyecto-final/kicad/documentación/pcb_silk.pdf

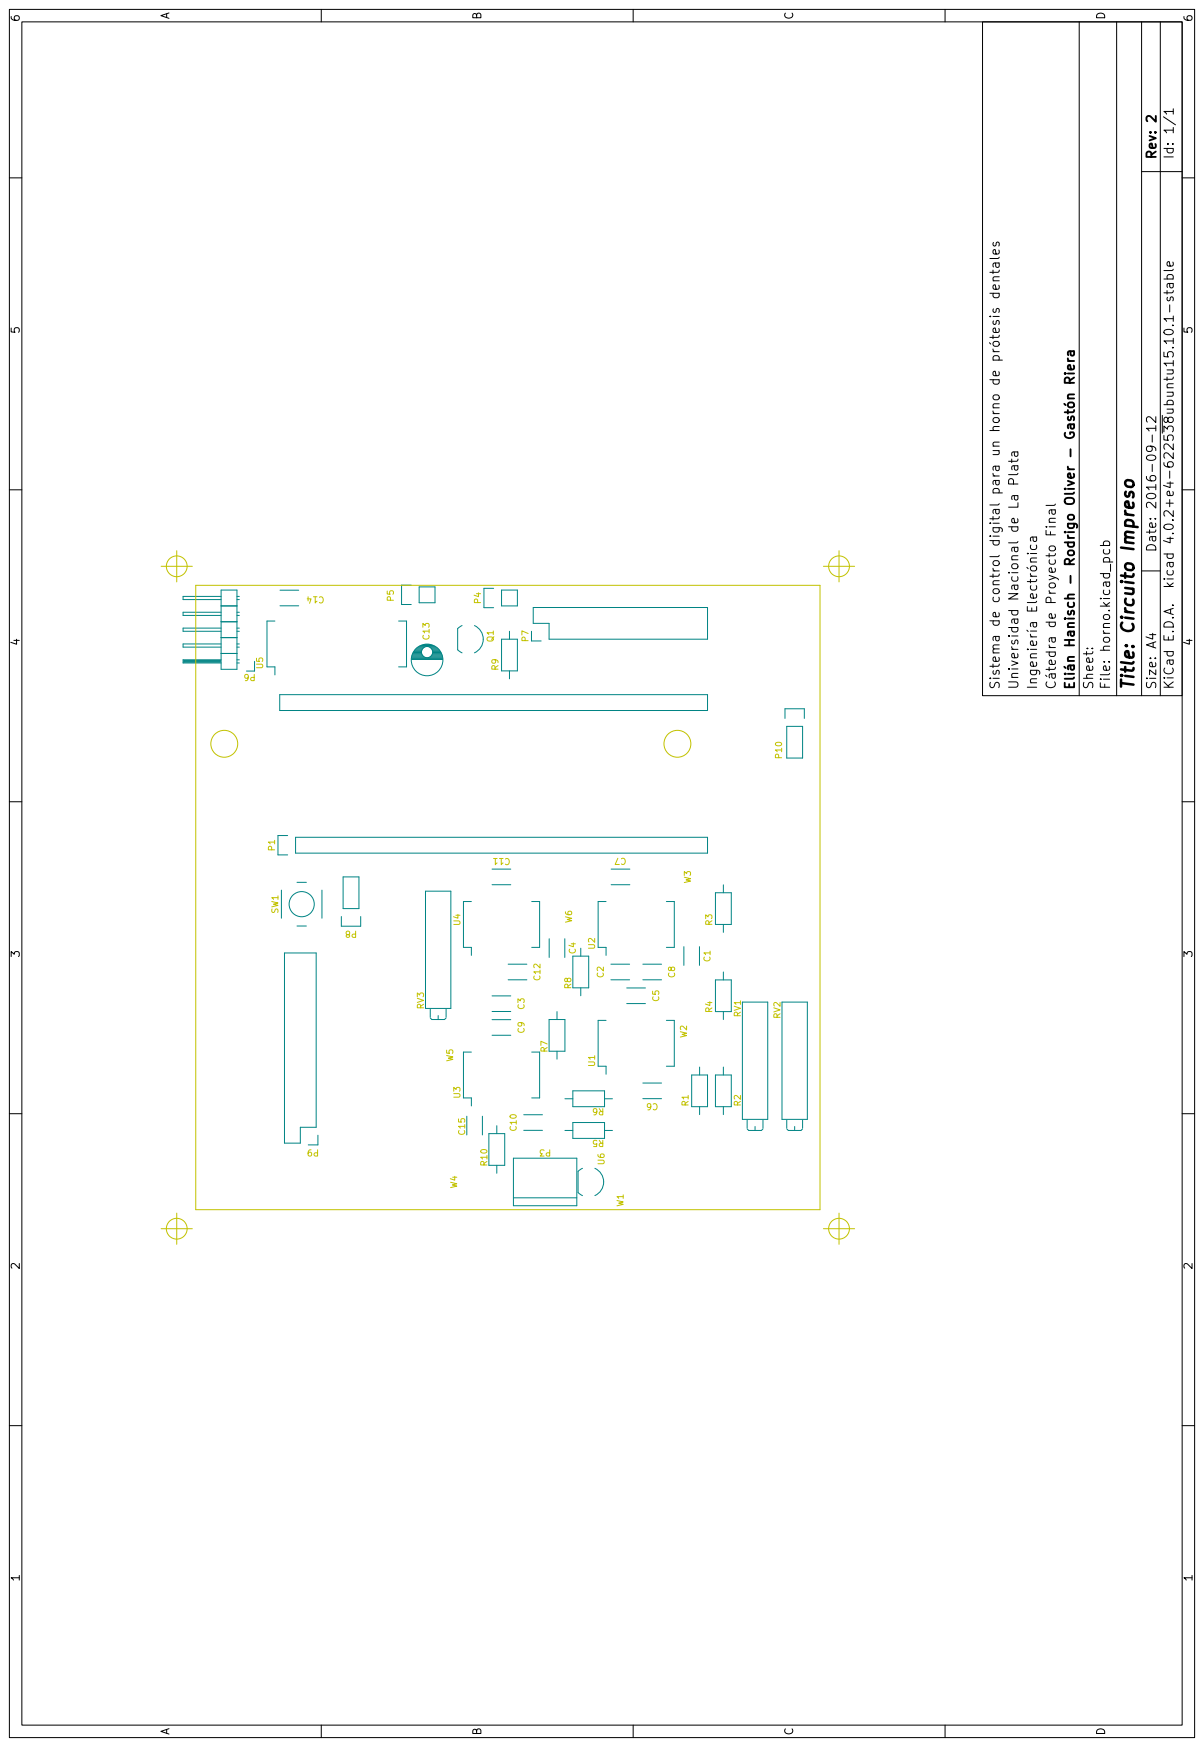
[picture p51: page 1]
