m4v/Proyecto-final/kicad/pcb/horno-B.Cu.pdf

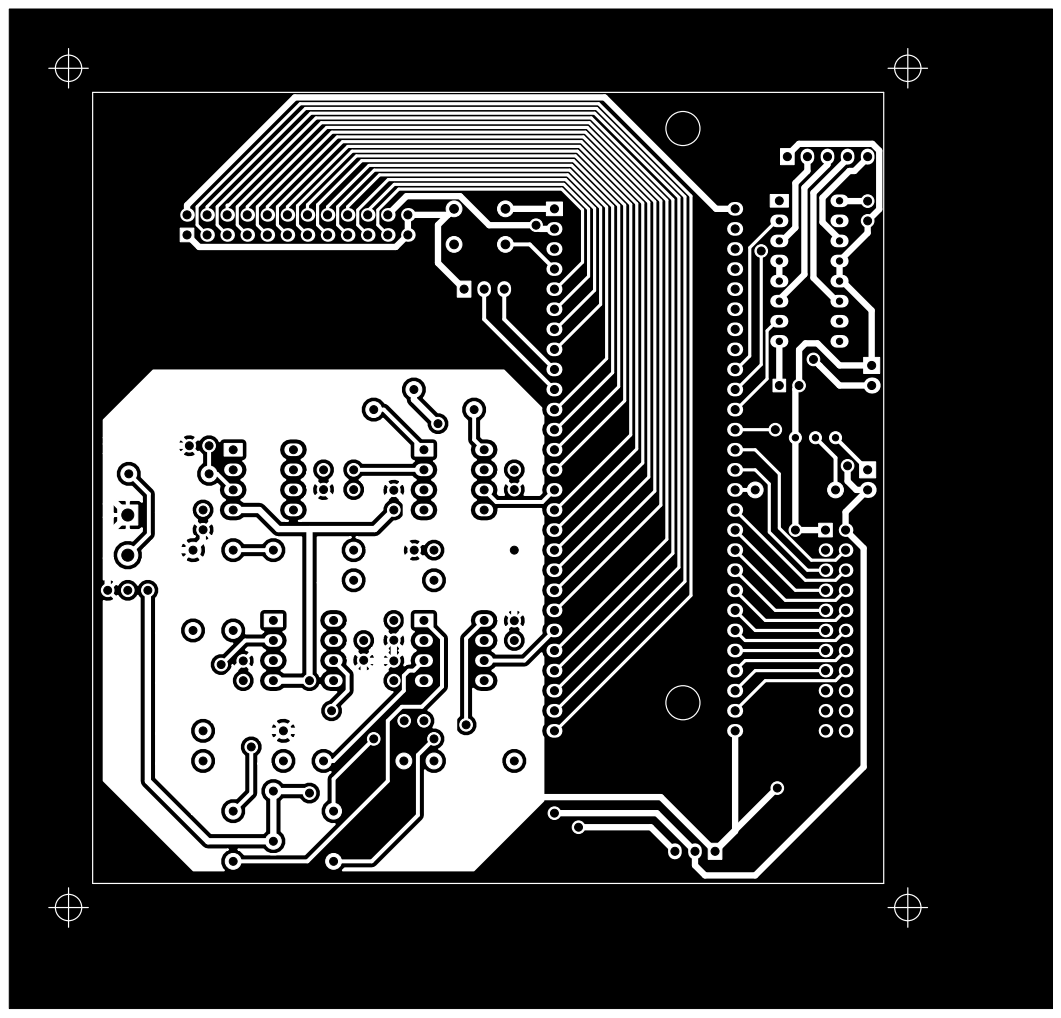
[picture p52: page 1]
