m4v/Proyecto-final/kicad/pcb/horno-F.Cu.pdf

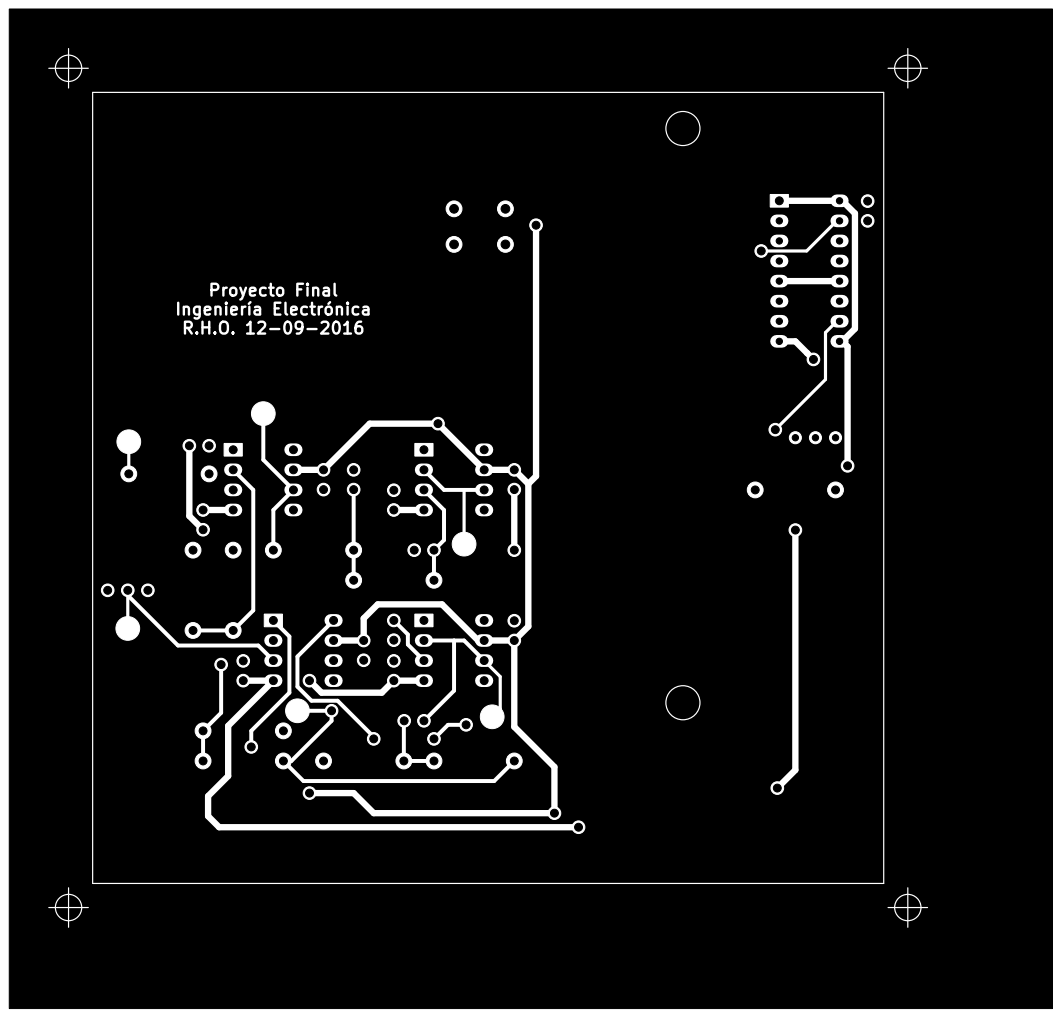
[picture p53: page 1]
