m4v/Proyecto-final/(list of files, drawings)

Other design files:
kicad/horno.dsn
