m4v/Proyecto-final/kicad/horno.kicad_pcb

## KiCad design kicad/horno.kicad_pcb (2016-11-27)

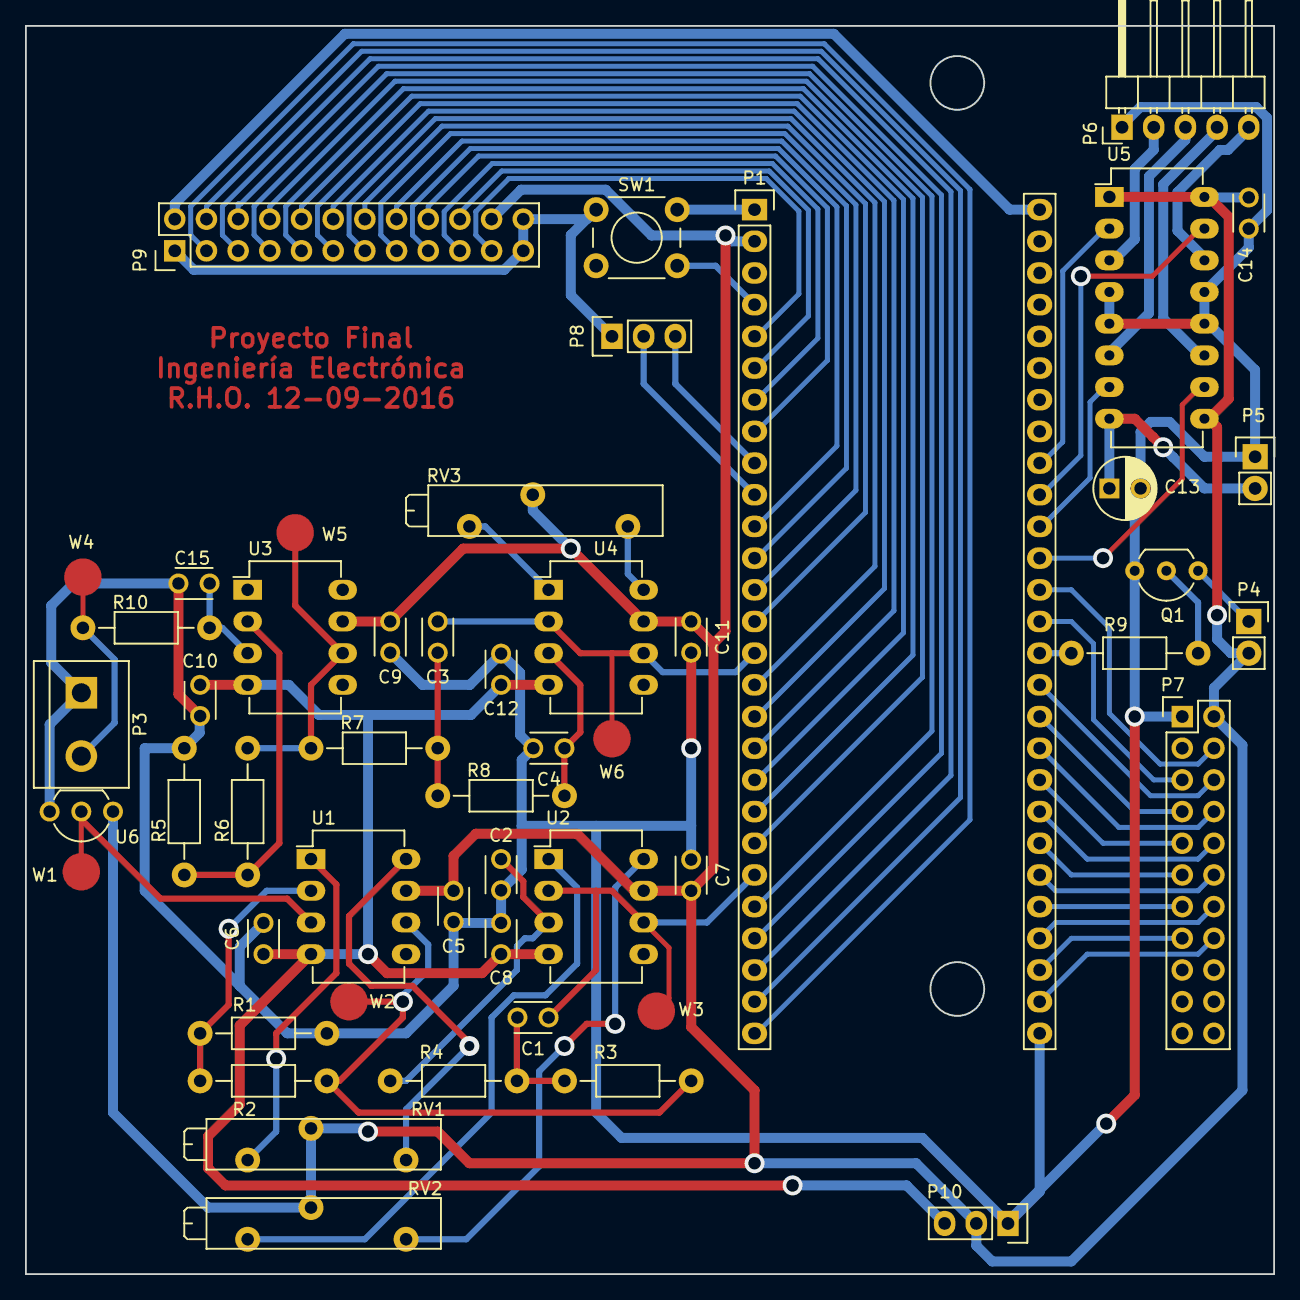
[picture p62: board horno.kicad_pcb from above]

Board: 2 copper layers, 100.1 x 100.1 mm, 51 parts (0 on the bottom side), 71 nets.

Parts:
C1, C2, C3, C4: 220nF; C_Disc_D3_P2.5
C5, C7, C9, C11, C14: 0,1uF; C_Disc_D3_P2.5
C6, C8, C10, C12: 0.1uF; C_Disc_D3_P2.5
C13: 1uF; C_Radial_D5_L6_P2.5
C15: C; C_Disc_D3_P2.5
P1: LPC1769; Pin_Header_LPCXpresso_LPC1769
P3: Termocupla; bornier2
P4: TRIAC; Pin_Header_Straight_1x02
P5: 24V; Pin_Header_Straight_1x02
P6: Motor; Pin_Header_Angled_1x05
P7: Pantalla; Pin_Header_Straight_2x11
P8: UART; Pin_Header_Straight_1x03
P9: GPIO; Pin_Header_Straight_2x12
P10: Alimentación; Pin_Header_Straight_1x03
Q1: BC547; TO-92_Inline_Wide
R1: 10k; Resistor_Horizontal_RM10mm
R2, R3, R7: 56k; Resistor_Horizontal_RM10mm
R4, R8: 330k; Resistor_Horizontal_RM10mm
R5: 1,5k; Resistor_Horizontal_RM10mm
R6: 120k; Resistor_Horizontal_RM10mm
R9, R10: R; Resistor_Horizontal_RM10mm
RV1, RV2, RV3: POT; Potentiometer_Bourns_3005_Angular_ScrewFront
SW1: RST; SW_PUSH_6mm
U1, U2, U4: OP07; DIP-8_W7.62mm_LongPads
U3: LTC1050; DIP-8_W7.62mm_LongPads
U5: L293D; DIP-16_W7.62mm_LongPads
U6: LM35; TO-92_Inline_Wide
W1: Lm1; Measurement_Point_Round-SMD-Pad_Big
W2: Lm2; Measurement_Point_Round-SMD-Pad_Big
W3: Lm3; Measurement_Point_Round-SMD-Pad_Big
W4: Th1; Measurement_Point_Round-SMD-Pad_Big
W5: Th2; Measurement_Point_Round-SMD-Pad_Big
W6: Th3; Measurement_Point_Round-SMD-Pad_Big

Connections:
+3V3: P1.28, P9.2
+5V: C5.1, C7.1, C9.1, C11.1, C14.1, P1.2, P4.2, P7.2, P9.22, P10.2, RV1.2, RV2.2, RV3.2, U1.7, U2.7, U3.7, U4.7, U5.1, U5.9, U5.16, U6.1
+24V: C13.1, P5.2, U5.8
-5V: C6.1, C8.1, C10.1, C12.1, P10.3, U1.4, U2.4, U3.4, U4.4
/LPC1769/A0: P1.43, P7.6
/LPC1769/AD_LM35: C1.1, P1.22, U2.2, U2.6, W3.1
/LPC1769/AD_TERMOCUPLA: C3.1, P1.15, U4.2, U4.6, W6.1
/LPC1769/CS: P1.52, P7.15
/LPC1769/D0: P1.44, P7.7
/LPC1769/D1: P1.45, P7.8
/LPC1769/D2: P1.46, P7.9
/LPC1769/D3: P1.47, P7.10
/LPC1769/D4: P1.48, P7.11
/LPC1769/D5: P1.49, P7.12
/LPC1769/D6: P1.50, P7.13
/LPC1769/D7: P1.51, P7.14
/LPC1769/GPIO0: P1.27, P9.3
/LPC1769/GPIO1: P1.26, P9.4
/LPC1769/GPIO2: P1.25, P9.5
/LPC1769/GPIO3: P1.24, P9.6
/LPC1769/GPIO4: P1.23, P9.7
/LPC1769/GPIO5: P1.21, P9.8
/LPC1769/GPIO6: P1.20, P9.9
/LPC1769/GPIO7: P1.19, P9.10
/LPC1769/GPIO8: P1.18, P9.11
/LPC1769/GPIO9: P1.17, P9.12
/LPC1769/GPIO10: P1.16, P9.13
/LPC1769/GPIO11: P1.14, P9.14
/LPC1769/GPIO12: P1.13, P9.15
/LPC1769/GPIO13: P1.12, P9.16
/LPC1769/GPIO14: P1.11, P9.17
/LPC1769/GPIO15: P1.8, P9.18
/LPC1769/GPIO16: P1.7, P9.19
/LPC1769/GPIO17: P1.6, P9.20
/LPC1769/GPIO18: P1.5, P9.21
/LPC1769/PWM: P1.42, R9.2
/LPC1769/RD: P1.40, P7.4
/LPC1769/RST: P1.53, P7.16
/LPC1769/S1: P1.36, U5.2
/LPC1769/S2: P1.38, U5.7
/LPC1769/S3: P1.39, U5.10
/LPC1769/S4: P1.37, U5.15
/LPC1769/WR: P1.41, P7.5
/Motor paso a paso/OUT1: P6.2, U5.3
/Motor paso a paso/OUT2: P6.3, U5.6
/Motor paso a paso/OUT3: P6.4, U5.11
/Motor paso a paso/OUT4: P6.5, U5.14
GND: C2.2, C4.2, C5.2, C6.2, C7.2, C8.2, C9.2, C10.2, C11.2, C12.2, C13.2, C14.2, C15.2, P1.54, P3.1, P5.1, P6.1, P7.1, P10.1, Q1.3, R1.2, R5.2, U5.4, U5.5, U5.12, U5.13, U6.3
GNDD: P1.1, P8.1, P9.1, P9.23, P9.24, SW1.1
unnamed: C1.2, R3.1, R4.2
unnamed: C2.1, R4.1, U2.3
unnamed: C3.2, R7.1, R8.2
unnamed: C4.1, R8.1, U4.3
unnamed: C15.1, R10.1, U3.3
unnamed: P1.4, SW1.2
unnamed: P1.9, P8.3
unnamed: P1.10, P8.2
unnamed: P3.2, R10.2, W4.1
unnamed: P4.1, Q1.1
unnamed: Q1.2, R9.1
unnamed: R1.1, R2.2, U1.2
unnamed: R2.1, R3.2, U1.6, W2.1
unnamed: R5.1, R6.2, U3.2
unnamed: R6.1, R7.2, U3.6, W5.1
unnamed: RV1.1, U1.8
unnamed: RV1.3, U1.1
unnamed: RV2.1, U2.8
unnamed: RV2.3, U2.1
unnamed: RV3.1, U4.8
unnamed: RV3.3, U4.1
unnamed: U1.3, U6.2, W1.1
