m4v/Proyecto-final/firmware/horno/inc/fuentes.h

/*
 * fuentes.h
 *
 *  Created on: Nov 12, 2016
 *      Author: Elián Hanisch, Gastón Riera y Rodrigo Oliver
 *
 *  bitmaps de las fuentes e imágenes del diplay
 */

#ifndef FUENTES_H_
#define FUENTES_H_


/* estructura para guardar bloques de 32x42 píxeles */
typedef struct {
	const uint32_t linea[42];
} BLOQUE42_T;


const uint8_t flecha[12]= {0xF0,0xF0,0xF0,0xF0,0xF0,0x00,0x80,0xC0,0xE0,0xF0,0xF8,0xFD};
const uint8_t dos_puntos[42] = {
		0x00,0x00,0x00,0x00,0x00,0x00,0x00,0x00,0x00,
		0x00,0x00,0x00,0x00,0x1C,0x1C,0x1C,0x1C,0x00,
		0x00,0x00,0x00,0x00,0x00,0x00,0x00,0x1C,0x1C,
		0x1C,0x1C,0x00,0x00,0x00,0x00,0x00,0x00,0x00,
		0x00,0x00,0x00,0x00,0x00,0x00};

const uint8_t horno_pos_y_flecha[39]={
		220,212,204,196,188,180,172,168,
		168,168,168,168,168,168,168,168,
		168,168,168,162,155,150,145,140,
		135,130,125,121,121,121,121,121,
		121,121,121,121,121,121,121};

const BLOQUE42_T HORNO_DIGITO[] = {
	{{ /* número 0*/
		 0x00000000, 0x00000000, 0x00000000, 0x00000000, 0x00000000, 0x00000000, 0x00003E00,
		 0x0000FF80, 0x0003FFE0, 0x0003E3E0, 0x000780F0, 0x000780F0, 0x000F0078, 0x000F0078,
		 0x000F0078, 0x001E003C, 0x001E003C, 0x001E003C, 0x001E003C, 0x001E003C, 0x001E003C,
		 0x001E003C, 0x001E003C, 0x001E003C, 0x001E003C, 0x001E003C, 0x000F0078, 0x000F0078,
		 0x000F0078, 0x000780F0, 0x000780F0, 0x0003E3E0, 0x0003FFE0, 0x0000FF80, 0x00003E00,
		 0x00000000, 0x00000000, 0x00000000, 0x00000000, 0x00000000, 0x00000000, 0x00000000

	}},
	{{ /* número 1*/
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
	     0x00000000, 0x00000000, 0x00000000, 0x00000000, 0x00000000, 0x00000000, 0x00000000, 0x00000000,
	     0x00000000, 0x00000000, 0x00000000, 0x00000000, 0x00000000, 0x00000000, 0x00000000, 0x00000000,
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
	};

#endif /* FUENTES_H_ */
