m4v/Proyecto-final/firmware/horno/src/pwm.c

/*
 * pwm.c
 *
 *  Created on: 20 de oct. de 2016
 *      Author: Elián Hanisch, Gastón Riera y Rodrigo Oliver
 */

#if defined(NO_BOARD_LIB)
#include "chip.h"
#else
#include "board.h"
#endif

#include "pwm.h"
#include "horno.h"

typedef struct {
	uint32_t puerto:3;
	uint32_t pin:5;
} PUERTO_T;

static const PUERTO_T puerto_pwm = {2, 0};

/*
 * @brief  inicia/detiene el PWM
 * @param  estado: true, activar el PWM.
 *                 false, apagar el PWM.
 */
void Horno_pwm_activar(bool estado)
{
	if (estado) {
		Chip_IOCON_PinMuxSet(LPC_IOCON, puerto_pwm.puerto, puerto_pwm.pin,
							 IOCON_MODE_INACT | IOCON_FUNC1);

		Chip_PWM_Enable(LPC_PWM1);
	} else {
		Chip_PWM_Disable(LPC_PWM1);

		/* para asegurar apagar el PWM lo pasamos a GPIO con r de pulldown.
		 * de lo contrario la salida puede quedar en alto cuando no es lo que queremos */
		Chip_IOCON_PinMuxSet(LPC_IOCON, puerto_pwm.puerto, puerto_pwm.pin,
							 IOCON_MODE_PULLDOWN | IOCON_FUNC0);

	}
	horno_pwm.activo = estado;
}

/*
 * @brief Configura el período del PWM
 * @param ms tiempo en milisegundos
 */
void Horno_pwm_periodo(uint32_t ms)
{
	horno_pwm.periodo = ms;
	uint32_t ticks = Chip_Clock_GetPeripheralClockRate(SYSCTL_PCLK_PWM1) / 1e3;
	Chip_PWM_SetMatch(LPC_PWM1, 0, ms*ticks);
	Chip_PWM_LatchEnable(LPC_PWM1, 0);
	Horno_pwm_ciclo(horno_pwm.dc); // actualizamos el valor del MR1
}

/*
 * @brief Configura el ciclo de trabajo del PWM
 * @param dc: ciclo de trabajo, entre 0.0 y 1.0
 */
void Horno_pwm_ciclo(float dc) {
	if (dc > 1) {
		dc = 1;
	} else if (dc < 0) {
		dc = 0;
	}

	horno_pwm.dc = dc;
	uint32_t pd = LPC_PWM1->MR0;
	Chip_PWM_SetMatch(LPC_PWM1, 1, (uint32_t)(pd * dc));
	Chip_PWM_LatchEnable(LPC_PWM1, 1);
}

/*
 * @brief Inicialización del PWM.
 */
void Horno_pwm_init(void) {
	Chip_PWM_SetControlMode(LPC_PWM1, 1, PWM_SINGLE_EDGE_CONTROL_MODE, PWM_OUT_ENABLED);

	Horno_pwm_periodo(PWM_PERIODO);
	Horno_pwm_ciclo(0.5);

	Chip_PWM_ResetOnMatchEnable(LPC_PWM1, 0);
	Chip_PWM_Init(LPC_PWM1);
}
