m4v/Proyecto-final/firmware/horno/inc/teclado.h

/*
 * teclado.h
 *
 *  Created on: 22 de oct. de 2016
 *      Author: Elián Hanisch, Gastón Riera y Rodrigo Oliver
 */

#ifndef TECLADO_H_
#define TECLADO_H_

void Horno_teclado_init(void);
bool horno_teclado_deshabilitar_carga_datos;

uint8_t horno_teclado_linea_datos;
uint8_t horno_teclado_posicion_flecha;
#endif /* TECLADO_H_ */
