m4v/Proyecto-final/(commit log)

2016-06-20 código para manejar el motor paso a paso
2016-06-25 proyecto blinky
    para tenerlo a mano
2016-07-03 mover todos los archivos del programa al directorio firmware
    Recordar mover el directorio .metadata de LPCXpresso a firmware
    y cambiar el workspace, o crear el proyecto de nuevo.
2016-07-03 Usar las bibliotecas Redlib (nohost). Antes era Redlib (none).
    Para mandar la salida del printf al UART y utilizar las funciones
    de depurado hay que linkear con una bibliotecas particulares.
    Nohost es la misma que utiliza el ejemplo del ADC.
    Ver:
    http://www.support.code-red-tech.com/CodeRedWiki/LibraryVariants
    http://www.support.code-red-tech.com/CodeRedWiki/UsingPrintf
2016-07-03 Mensaje de inicio por el UART y remover el código de los botones del motor.
2016-07-03 bajarle la velocidad de parpadeo al led.
2016-07-04 probar mandar comandos al micro a través del UART
2016-07-04 utilizar el ADC.
    Resta ver el tema de la velocidad de conversion y de muestreo.
2016-07-04 agregar los ejemplos del adc y uart, para tener a mano.
2016-07-05 Usar el ADC con interrupción y prepararlo a para capturar algunas señales.
    Captura 80ms a 10kSamples/sec.
2016-07-13 cambios en las velocidades del ADC
    * bajar la velocidad de muestreo a 1 muestra por 1ms
    * bajar la velocidad de conversión de 200kS a 1,4kS
    * aumentar la cantidad de muestras de 800 a 1000
2016-08-09 Update en el LPXpresso
2016-08-09 Funciones que usamos jugando con el display 16x02
2016-08-10 Empecé con el display
    Porté las funciones de CMSIS a LPCOpen.
    Actualicé los pines referidos al Motor y los referidos al display.
2016-08-12 Creación de carpeta Otros
    También moví de lugar el archivo del 16x2
2016-08-12 Carga de los detalles correspondientes al display 320x240
2016-08-17 seteo correcto de los pines
2016-08-17 reestructiración de los controles
    El comando WAIT no lo usamos.
    Los controles /CS y /RES están siempre en HIGH y los pongo en el mismo
    pin.
2016-08-24 con el prog de pablo
2016-08-27 ahora anda el display
2016-08-28 implementar la función Horno_udelay para realizar retrasos.
2016-08-28 no ignorar los archivos .lib de Kicad
2016-08-28 Proyecto Kicad
    [AmpLM35.sch, AmpTermocupla.sch, LPC1769.sch, horno.kicad_pcb, horno.sch, motorPP.sch]
2016-09-02 modificaciones del proyecto Kicad
    [LPC1769.sch, horno.kicad_pcb, horno.sch, motorPP.sch]
2016-09-03 usar defines para mover A0, WR y RD. Sacar CS y dejarla siempre a cero.
2016-09-03 Implementar el pin de reset.
    Display_Init hace un reset al iniciar.
    [320240.c]
2016-09-03 sacar el bucle infinito de Display_Init.
    En lugar de eso, ejecutar Display_Init cada 5 seg desde el main.
2016-09-03 estas declaraciones están de más.
2016-09-08 Así anda
    Con estos cambios anda con el display de Pablo.
    - Borra el 1er layer
    - Escribe
2016-09-11 circuito y pcb terminado.
    [AmpLM35.sch, AmpTermocupla.sch, LPC1769.sch, horno.dsn, horno.sch, motorPP.sch]
2016-09-11 arreglar la comunicación UART que se rompió en el commit 98317cb8206e10074
2016-09-12 últimas modificaciones al impreso.
    [LPC1769.sch, horno.kicad_pcb]
2016-09-15 Acomodo de funciones y creación de nuevas
    Acomodo:
    - Fill text layer
    - Fill graphic layer
    Nuevas funciones:
    - Put pixel
    - Put rectangle
2016-09-16 Agregado funciones con píxels de Rodri
2016-09-16 Algunas cosas de rodri
2016-09-19 nueva funcion: Put_line
    works like a charm
    También puse los delays en los pasajes de comando y de parámetros en
    50us
2016-09-20 estaba mal puestas las etiquetas de las resistencias del amp. del lm35.
    Las resistencias R1 y R2 tenían las resistencias intercambiadas.
    [horno.kicad_pcb]
2016-09-20 archivos del BOM del proyecto
    [horno.csv, horno_BOM.ods]
2016-09-20 ignorar backups de kicad
2016-09-21 Dejé que se dibuje un rectángulo en la parte inferior del display. Mejora de la legibilidad del código.
2016-09-21 mover las funciones para arriba así no tienen que estar declaradas.
    Poner el código de prueba en la función Horno_Display_Test en lugar
    de tenerlo dentro de la función de inicialización.
2016-09-21 renombrar Display_Init a Horno_Display_Init y llamarlo desde Horno_Init
    Agregar en el main un llamado a Horno_Display_Test.
2016-09-21 usar Command_Write con los defines en lugar de números en hexa
2016-09-22 GRAYSCALE no se usa en el código de inicialización de gastón así que mejor comentarlo.
2016-09-22 el encabezado 320240.h estaba comentado totalmente.
    a veces no entiendo como esto antes estaba funcionando.
2016-09-22 fix warning: statement with no effect
    [320240.c]
2016-09-22 LPCXpresso insiste en cambiar los .cproject de los ejemplos...
2016-09-22 mover todos los includes a la carpeta horno/inc
2016-09-22 habilitar el código del ADC nuevamente
2016-09-28 scripts que usamos para leer datos
2016-09-28 mejorar el script, agregar un guardado de un registro
2016-09-30 cambios en los scripts de Octave
2016-09-30 mediciones, graficos y scripts de gnuplot
    * archivos .csv
    datos de las mediciones
    * archivos .gp
    scripts de gnuplot
    [captura_continua_29-Sep-2016_20:00:26.csv, horno_primer_ensayo.csv, lm35_circuito.csv, lm35_circuito_2.csv, th_circuito_1.csv, th_circuito_2.csv, th_circuito_3.csv]
2016-10-01 modificiaciones que usamos para hacer los relevamientos de curvas
2016-10-01 última medición del horno
    [captura_continua_30-Sep-2016_19:32:35.csv]
2016-10-01 script para hacer el ajuste de las mediciones a una respuesta a un escalón
2016-10-01 graficos de los ajustes
2016-10-01 actualizar el gitignore
2016-10-01 usar el símbolo de tau en lugar de "tau" en los gráficos
2016-10-03 bajarle la cantidad de muestras al comando 'm' de 1000 a 100
    así la captura dura 10s en lugar de 100s
2016-10-03 mejora del script para hacer capturas
2016-10-04 leer los valores tanto de la termocupla como del lm35
    Medio desplolijo pero funciona.
2016-10-04 actualizar el script para que grafique los 2 AD
2016-10-06 datos de la última captura
    [captura_continua_04-Oct-2016_15:16:34.csv, captura_continua_04-Oct-2016_18:50:57.csv]
2016-10-07 modificaciones a los scripts de octave
2016-10-07 meter algunas variables estáticas dentro de un struct
2016-10-08 integrar el control del motor
2016-10-08 script para hacer el ajuste de la curva de enfriamiento
2016-10-08 actualizar el README
2016-10-12 script para simular la planta y pid
2016-10-20 mejora del control del motor
2016-10-22 drivers del pwm
2016-10-22 pwm más o menos andando
2016-10-22 configurado para accionar sólo el display
    Comentada la sección del ADC.
    En el caso de que no se comente lo del display, no funciona el display
    Con esto el display anda.
2016-10-22 Comentarios de funciones y curva de trabajo estática
    1- Creada función que grafica la curva de trabajo estática.
    2- Creados comentarios breves describiendo qué hace cada función
2016-10-22 Mejora función Put_line_waddr
    No tomaba bien el inicio de la coordenada. Ahora anda 10 puntos
2016-10-22 Agregado Funcion: static_curve
    Hace la curva estática. :)
2016-10-22 Upgrade de static_curve a static_curve_wsqare + limpieza de tests viejos
    1- Agregado del rectángulo a la función de la curva estática
    2- Borrado de las cosas viejas y tests ya obsoletos
2016-10-22 Funciones para el uso de la "flechita"
    - Clear_line_waddr: igual al put_line_waddr, pero pone un '0'en vez de
    un '1'
    - Set_arrow
    - Clear_arrow
2016-10-22 - Mejorada la función que pone los recuadros. - Ahora carga los 3 espacios
2016-10-22 Creada una función que mueve la flechita a lo largo de la curva estática.
2016-10-22 Texto en el recuadro izquierdo
2016-10-22 Creada la función: Put_string_waddr. Usando Put_string y Set_text_position.
2016-10-22 Creada función para poner números. Hasta este momento sólo están los números 1 y 8.
2016-10-22 Creados todos los numeros de la función Put_Number. Testeados que anden en los 10 espacios del display.
2016-10-22 Creada función que borra los numeros. Hasta acá queda andando una suerte de test que recorre todos los números.
2016-10-22 Funcion que testea los numeros grandes: Num_grandes_test y los va imprimiendo y borrando.
2016-10-22 test del display dentro del while de horno.c
2016-10-22 windows no acepta archivos que tengan ':' en el nombre.
    [captura_continua_04-Oct-2016_151634.csv, captura_continua_04-Oct-2016_185057.csv, captura_continua_29-Sep-2016_200026.csv, captura_continua_30-Sep-2016_193235.csv]
2016-10-22 me olvidé borrar los archivos
    [captura_continua_04-Oct-2016_15:16:34.csv, captura_continua_04-Oct-2016_18:50:57.csv, captura_continua_29-Sep-2016_20:00:26.csv, captura_continua_30-Sep-2016_19:32:35.csv]
2016-10-22 Arreglar conflictos con el led.
    [motor.c, pwm.c]
2016-10-22 Actualizar los pines del diplay a los del PCB
2016-10-22 primer trabajo para graficar números bien
2016-10-22 cambios de los cprojects
2016-10-22 adc.h y adc.c : linealizacion de termocupla y lm35. Mas adelante sera todo respecto a adc
    teclado.h y teclado.c : manejo de teclado
2016-10-22 codigo que falta para el teclado
2016-10-23 estructuras para definir todos los números
2016-10-23 script octave e imagen usada para generar los números
2016-10-23 mejora del PWM
    Cuando se desactiva el PWM ahora se asegura que no quede en alto la salida.
2016-10-23 cambios en el driver del PWM
2016-10-23 Función que borra los números.
2016-10-23 Borrado de funciones de numeros grandes que no usamos más. También limpieza de cosas comentadas que estaban de más.
2016-10-23 Funcioncita que recorre las 4 posiciones de números. Escribe y borra el numero.
2016-10-24 armado de PI y lazo de control
2016-10-24 encabezado para el pid y lazo de control
2016-10-24 Intente quitar cosas que molestaban para pasarlas al adc.c Lo que esta en el while(1) no lo quise tocar. La estructura fue a parar al adc.h Habia variables que se usan en el while(1) que las puse en 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
2016-10-24 Entra el sistickhandler() que viene del horno.c
2016-10-24 Se agregan cosas que vienen de horno.c
2016-10-24 van de nuevo porque comente unas cosas y no los habia guardado antes de comietear
2016-10-24 Imagenes de la flechita en 2 tamaños
2016-10-24 Mejora la función que borra los números. Edición sugerida por Elián.
2016-10-25 configurar el ciclo de trabajo del PWM desde el teclado
2016-10-25 mejora del ingreso de datos
    Uno presiona # para ingresar el dato en memoria y posteriormente usa C o D para configurar el ciclo de trabajo o periodo del PWM con el dato ingresado.
2016-10-25 Creado función Horno_grafico_entero. También tener en cuenta el define de Horno_grafico_temperatura.
2016-10-25 scriptsito de octave para convertir la imagen de la flecha.
2016-10-26 se cambio el nombre de los valores de temperatura en grados
2016-10-26 se cambio la definicion del PI Para que quede PI = Kp + Ki * Ts se cambio tambien nombres de variables de temperatura que se modificaron en control.h
2016-10-26 se borro el codigo comentado
2016-10-26 creada funcion que le entra con un numero y pone los datos en los datos del programa: Horno_grafico_datos
    También creados defines descriptivos.
2016-10-26 Correcta configuración de las funciones que ponen datos.
    [320240.c]
2016-10-26 limpieza de comentarios y cosas que estaban de más
2016-10-26 Limpieza de código, comentarios de más.
2016-10-26 cosas que faltaron
2016-10-26 corregir error de linkeo
    [adc.h]
2016-10-26 Configuración para mostrar datos del PWM e ingresos por teclado
2016-10-26 Imagen de 24x42 del grado centígrado
2016-10-26 Creada la sección del grado centígrado dentro de la estructura. Puesto para que se muestre en el bucle infinito
2016-10-26 completar la linealización de las mediciones.
2016-10-27 mostrar los valores del AD a la salida del UART
2016-10-27 borrada un comentario que está de mas.
2016-10-27 Creada función que pone los datos del pwm en la parte izquierda del display
2016-10-27 Dentro del display_test usamos la funcion recien creada para mostrar los datos del pwm. También algunos commentarios menos.
2016-10-27 Agregada la función Put_string_waddr al header. Creo que lo hice mal porque la ruta no es /horno/scr/
2016-10-27 Mejorada la función Horno_grafico_datos_pwm, para que borre los campos antes de escribirlos
2016-10-27 Agregadas a los handlers para que muestren la tecla presionada. También muestra el dato aceptado y se actualizan los datos como corresponde.
2016-10-28 Descomentar el código del UART
2016-10-28 no mostrar teclas presionadas en el display.
    Hace que las teclas no sean respondan rápidamente
2016-10-29 cambios en el muestreo del ADC
    Systick_Handler vuelve a init.c
2016-10-29 refactorizar el bucle principal.
    Se elimina buena parte del código para muestrear el AD que ya cumplió su función.
2016-10-29 Cambiamos el apagado del PWM para que no use una interrupción
    en lugar de esperar a que el PWM pase a bajo, cambiamos el puerto a GPIO con R de pull-down.
2016-10-29 No usar el LED de la placa.
    Que cada uno use el LED localmente como quiera, así nos ahorramos el problema de querer usarlo para cosas diferentes
    [adc.c]
2016-10-29 Código para prender y apagar el PWM desde el UART
2016-10-29 mover el define del periodo del PWM a inti.h
2016-10-29 grafico.h tiene que ir a la carpeta de includes
2016-10-29 si se cambia el periodo del PWM, mantener el ciclo de trabajo
2016-10-29 poner las constantes de polinomio como static const
    static para limitarlas solo a adc.c y const porque son constantes
2016-10-29 mover la inicialización del adc a adc.c
2016-10-29 th_cantidad y lm_cantidad son siempre iguales, usar una sola.
    No vamos a usar un promedio distinto para el LM35 y la termocupla.
2016-10-29 ya somos grandes y no necesitamos tener los ejemplos en el proyecto.
2016-10-30 por si necesito reiniciar el contador de muestras
2016-10-30 el periodo de muestreo del PI es el mismo del AD promediado
2016-10-30 cambiar el periodo del PWM a 10 ciclos de la red
2016-10-30 pasar el dato del ciclo de trabajo con más precisión
2016-10-30 actualizar el script de Octave para capturar datos con lazo cerrardo
2016-10-30 Agregar comando para abrir el lazo por si hace falta
2016-10-30 esta variable tiene que ser volatile
    Sin el volatile, si uno compila en modo Release el optimizador la elimina.
2016-10-30 Cambios para que el modo Release compile
    Agregar horno/inc en los includes y usar Redlib(nohost)
2016-10-31 Tecla A enciende y apaga el PWM.
2016-10-31 Acomodo mensaje que se muestra por la tecla A
2016-10-31 El "°C" dentro de la función que pone los numeros grandes.
2016-10-31 Borradas funciones que trabajaban sobre una flecha que no usamos más.
2016-10-31 Texto: Datos del PWM dentro de la función que pone los datos
2016-10-31 Leyenda "TEMPERATURA: " se pone con la función de los números.
2016-10-31 Funciones que ponen temperatura y tiempo con numeros grandes.
2016-10-31 Quitadas lineas que fueron a otras funciones
2016-11-02 no usar 2 puntos en los nombres de archivo
2016-11-02 datos de los ensayos del PI
    [captura_PI_01-Nov-2016_134450.csv, captura_PI_01-Nov-2016_170030.csv, captura_PI_01-Nov-2016_173732.csv, captura_PI_01-Nov-2016_184800.csv]
2016-11-02 cambios en el script de captura
2016-11-02 agregar método para configurar la referencia desde el UART
2016-11-02 comprimir estas mediciones que son particularmente grandes
    [captura_continua_29-Sep-2016_200026.csv, captura_continua_30-Sep-2016_193235.csv]
2016-11-02 Quitada la condición del if Adoptada la sugerencia de elián, usar horno_pwm.activo como condición.
2016-11-02 Muestra del tiempor estante. Esto es sólo una muestra para ver cómo queda.
2016-11-02 Funcion seteo referencia con teclado. Con la tecla B seteamos la referencia. Habría que hacer una función aparte, esto es sólo temporal.
2016-11-02 Imagen de los dos puntos
2016-11-03 Función que pone el tiempo restante. Lo hace en numeros grandes y en formato HH:MM.
2016-11-03 Con la tecla B pone el numero en tiempo restante. También está el tickling cada 1 segundo y también está todo listo para que descuente cada 1 minuto.
2016-11-03 Letras E y R para condición de ERROR
2016-11-03 Bitmaps letras + funciones. Mejorada funcion de tiempo, pone condición de error. También creada función FIN.
    [grafico.c, grafico.h]
2016-11-03 función FIN implementada. Queda la config para testeo con la tecla B.
2016-11-04 Borrada cosas viejas de la flecha.
2016-11-04 anti windup condicionando la referencia
2016-11-04 activar PI por teclado y actulizar ciclo de trabajo en el display
2016-11-04 prender el motor PP con el teclado
2016-11-04 Logo de FI
2016-11-04 Comentarios y reordenada de las funciones
2016-11-06 R de pulldown para que la resistencia no se energice con un reset.
    Cuando el microcontrolador está pasando por un reset, la pata del PWM está flotando y alcanza para activar el transistor.
    [AmpLM35.sch, AmpTermocupla.sch, LPC1769.sch, horno.sch, motorPP.sch]
2016-11-06 fines de carrera detienen el motor.
2016-11-06 testeo de la flecha. y las funciones recién creadas
2016-11-06 Mejora de la función que pone la hora.
2016-11-08 Actualizar los esquemáticos
    [AmpLM35.sch, AmpTermocupla.sch, LPC1769.sch, horno.sch, motorPP.sch]
2016-11-09 implementación de 2 PI, uno para el secado y otro para la cocción.
2016-11-09 para subir la plataforma el giro es al revés
2016-11-09 Estas líneas son redundantes.
    en cada paso solo cambian 2 pines de estado.
2016-11-09 maquina de estados que implementa el programa
2016-11-09 Cambiar el código del fin de carrera.
    Utilizar la interrupción por flanco se complica por los rebotes, directamente detectar el nivel del fin de carrera y la cantidad de pasos es más sencillo y robusto.
2016-11-09 Test de la flechita con estados. Camiando según un tiempo.
2016-11-10 Programar el motor para que cierre cuando se cumpla la temp. de secado
2016-11-10 nuevos valores para el PI
2016-11-10 Los datos del programa donde van. Pasados a grafico.c y que se le carguen los datos que corresponden
2016-11-10 Mejora curva+recuadro+cómo recorre la flecha
2016-11-11 Ingreso de datos por teclado. Quedó configurado que presionar A comienza y detiene el PWM sólo con fines de testing
2016-11-11 Función de tiempo le entramos con segundos
2016-11-11 integración del programa con el display
2016-11-12 Corregir la conversión de segundos a minutos/horas
2016-11-12 en lugar de ERR, que diga 99:99
2016-11-12 octave: el grafico de la ref. condicionada en rojo, y no iniciar el programa
2016-11-12 Todas las mediciones que hemos hecho pero aún no comitié
    [captura_PIMD_02-Nov-2016_190425.csv, captura_PIMD_02-Nov-2016_195121.csv, captura_PIMD_04-Nov-2016_105054.csv, captura_PIMD_04-Nov-2016_112641.csv, captura_PI_02-Nov-2016_143432.csv, captura_PI_02-Nov-2016_182955.csv, captura_continua_04-Nov-2016_142624.csv, captura_continua_04-Nov-2016_182624.csv]
2016-11-12 script para graficar multiples capturas
2016-11-12 comando para configurar el ciclo de trabajo desde el UART
2016-11-12 código para recalcular el tiempo restante cuando se cambia de estado
2016-11-12 Cambio posicion de numeros temperatura
2016-11-12 Modificaciones varias numeros grandes. - Movida hacia la derecha - Se borran los digitos de la temperatura
2016-11-12 Modificaciones en la curva estática. - La función está dentro de grafico.c - Se imprime la función cuando empieza el programa.
2016-11-12 Ajuste de tamaño recuadro izquierdo. - Datos mostrados - Alineaciones correspondientes. - Barra lvertical ajustada
2016-11-12 agregar los jumpers para poner la entrada del LM35 a tierra
    [_saved_AmpLM35.sch, _saved_LPC1769.sch, _saved_motorPP.sch]
2016-11-12 estos archivos no van
    [_saved_AmpLM35.sch, _saved_LPC1769.sch, _saved_motorPP.sch]
2016-11-12 Funcion flechita(cursor) para ingreso datos.
2016-11-12 Renombrado y acomodo funcion que pone los recuadros.
2016-11-12 Include para que no dé warnings.
2016-11-12 sacar cosas que quedaron superfluas
2016-11-12 Flecha/cursor para ingresar datos
2016-11-12 Habilitar/deshabilitar carga de datos. - Cuando se inicia el programa se deshablita la carga de datos.
2016-11-12 Mejora y optimización de flechita/cursor
2016-11-13 renombrar las mediciones del programa
    [captura_programa_09-Nov-2016_145400.csv, captura_programa_09-Nov-2016_195356.csv, captura_programa_10-Nov-2016_152524.csv, captura_programa_11-Nov-2016_175802.csv]
2016-11-13 agregar una pantalla de inicio
2016-11-14 Mejora para que no se muestre la imagen.
2016-11-14 Mejora limpieza de la pantalla inicio. - Creada función que limpia el 2do payer. - Solución más elegante que meter todo el display_init()
2016-11-15 gráficos del programa de cocción
2016-11-15 script para graficar las mediciones
2016-11-15 reducir el tiempo de la pantalla de inicio
2016-11-16 resultados del último ensayo
    [captura_programa_15-Nov-2016_173219.csv]
2016-11-16 Corrección de cambios para que ande la función de la flecha
2016-11-17 gráficos de las mediciones con el osciloscopio.
    [osciloscopio_PWM_WA000001.CSV, osciloscopio_PWM_WA000002.CSV, osciloscopio_PWM_WA000007.CSV]
2016-11-17 Modificaciones varias. - Nada que cambie el funcionamiento. - Cosas de sintaxis y elegancia del codigo
2016-11-17 mejorar el código de la flecha en el gráfico.
2016-11-17 optimización en la función que grafica dígitos.
2016-11-17 limpiar el gráfico cuando cambia el estado del programa y no cuando se presiona B.
2016-11-18 cambio del periodo del PWM
2016-11-18 asegurar que la plataforma siempre esté abierta.
2016-11-18 nuevo ensayo
    [captura_programa_17-Nov-2016_180946.csv]
2016-11-18 poner el estado en español
2016-11-18 que el LED parpadeé cuando captura una muestra de temperatura.
2016-11-18 Unir las funciones para activar/detener el PWM en una sola.
    Para que sea consistente con la función para activar el control.
2016-11-18 mover horno_estado a la estructura en horno_programa
2016-11-18 arreglo tentativo para los cuelgues en Horno_udelay
    [delay.c]
2016-11-18 meter las variables globales de delay.c en una estructura
2016-11-18 mover la variable contador dentro de la estructura.
2016-11-18 actualizar el esquematico rev3
    [AmpLM35.sch, AmpTermocupla.sch, LPC1769.sch, horno.sch, motorPP.sch]
2016-11-18 Revert "arreglo tentativo para los cuelgues en Horno_udelay"
    This reverts commit 310435ad88b52523e0398aa4f8ab7ab5d1a16ac1.
    [delay.c]
2016-11-19 arreglar el bloqueo del generador de retardos
    [horno.c]
2016-11-21 archivos de matlab usados para sintonizar el PI
2016-11-21 Poner la pata de RST del display a 5V
    [LPC1769.sch, horno.sch]
2016-11-22 mediciones del circuito del lm35 que nose porque no commitié antes.
    [circuito_lm35_1.csv, circuito_lm35_2.csv, circuito_lm35_3.csv, circuito_lm35_4.csv, circuito_lm35_5.csv]
2016-11-23 función para bajar la plataforma en cierto tiempo (que no usamos)
2016-11-23 cambiar de estado en la temperatura consigna y no a 10° menos
2016-11-23 mediciones durante la cocción de la pieza.
    [captura_PI_01-Nov-2016_173732.csv, captura_coccion_22-Nov-2016_195439.csv, captura_coccion_23-Nov-2016_130902.csv]
2016-11-26 scripts para graficar mediciones
2016-11-26 gráficos de la presentación de la parte de control
2016-11-26 algunos detalles de las mediciones
2016-11-26 comentarios y asegurar que todos los archivos tienen bien los encabezados.
2016-11-26 comentarios y mover unos defines a adc.c
2016-11-26 vaya uno a saber como es que esto funcionaba sin esta funcion en el encabezado.
2016-11-26 arreglar el formato del título de este script
2016-11-26 Estos archivos no se usa en el proyecto
2016-11-27 Borrar funciones que no usamos más.
2016-11-27 agregar LED indicador del PWM.
    [AmpTermocupla.sch, LPC1769.sch, horno.sch, motorPP.sch]
2016-11-27 actualizar esquematicos de la revisión 3
2016-11-27 actualizar el readme del repo
2016-11-27 actualizar el esquemático rev2
2016-11-27 Comentarios ++ - brief de las funciones - Emprolijadas de algunos detalles - Cambio de display_test a display_static
2016-11-27 Comentarios++ y detalles varios. - Brief de las funciones. - Emprolijada - Ordenada header con funciones
2016-11-27 Agregados los Briefs de los handlers
2016-11-27 corregir la posición de las etiquetas de los componentes en el pcb
    [horno.kicad_pcb]
2016-12-02 gráficos del informe
    [datos_ajuste_modelo_GC.csv, datos_ajuste_modelo_GS.csv, datos_validacion_modelo_GC_1.csv, datos_validacion_modelo_GS_1.csv, datos_validacion_modelo_GS_2.csv, datos_validacion_modelo_GS_3.csv, datos_validacion_modelo_GS_4.csv, simulacion_alta_temperatura.csv]
2016-12-02 faltan los pdf del pcb
